r078786/PE2_BS/Bluetooth_music_box/Foto's en filmpjes/pcb_zonder_scherm.PNG

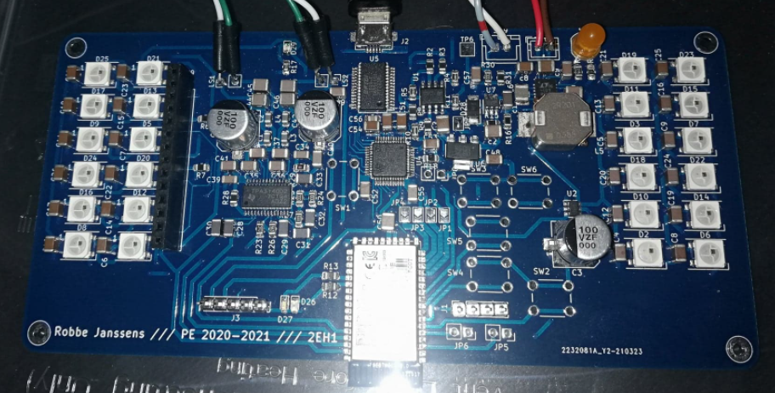
Bluetooth_music_box/Foto's en filmpjes/pcb_zonder_scherm.PNG
