r078786/PE2_BS/Bluetooth_music_box/Foto's en filmpjes/pcb_met_scherm.PNG

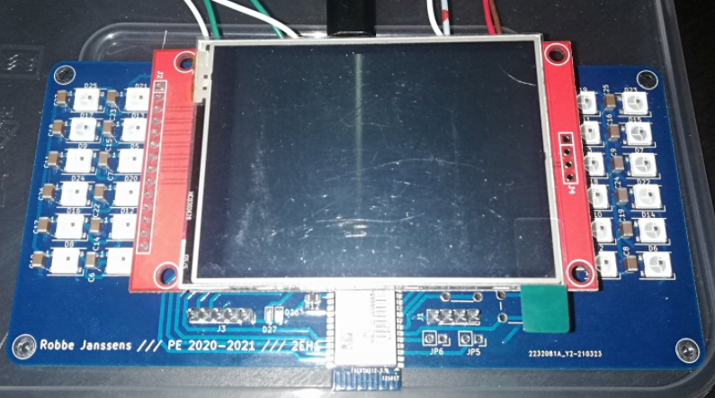
Bluetooth_music_box/Foto's en filmpjes/pcb_met_scherm.PNG
