r078786/PE2_BS/Bluetooth_music_box/Verdediging.pptx

## BlueTooth speaker

Practice Enterprise 2020 – 2021
Thomas More
2EH1: Robbe Janssens

## Wat ?

- Inleiding
- Eigenlijke inhoud
- Besluit

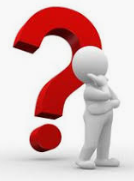
[picture p19: figure]

## Slide 3

Inleiding

- BlueTooth Speaker
- Programmeer-, mechanische, elektronische kennis

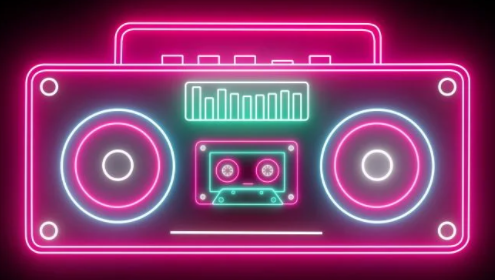
[picture p20: figure]
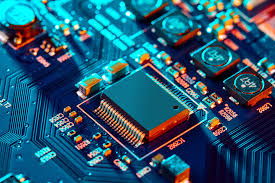
[picture p21: figure]
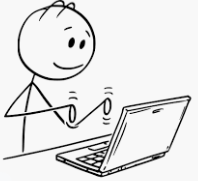
[picture p22: figure]

## Slide 4

Inleiding

- Duidelijk idee
  - (blok)schema’s

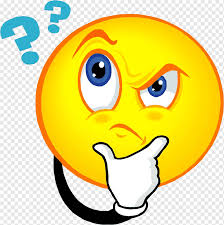
[picture p23: figure]

## Slide 5

Inleiding

- Componenten

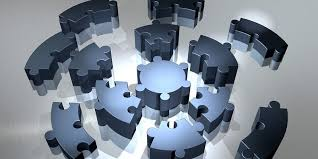
[picture p24: figure]
The 5 Main Components of ERP Software You Need

## Slide 6

Inleiding

- Schema / PCB

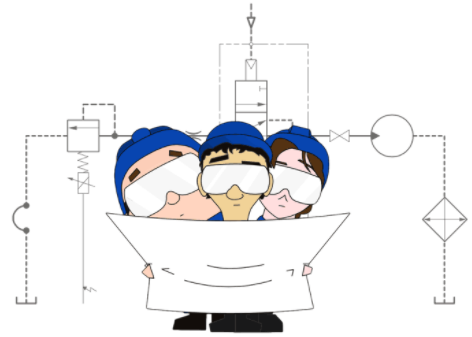
[picture p25: figure]
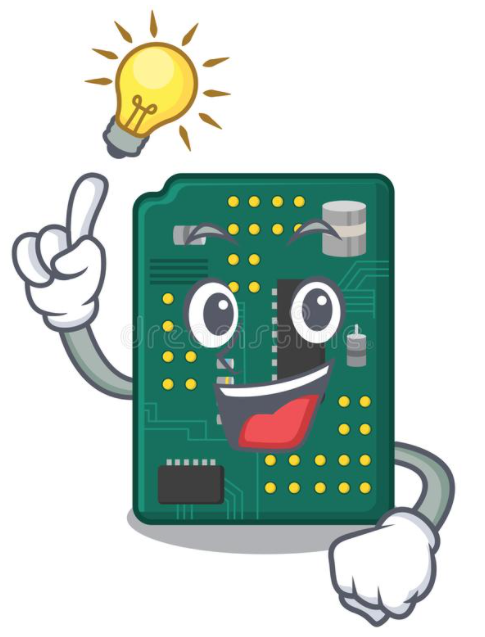
[picture p26: figure]

## Slide 7

Inleiding

- Mechanica

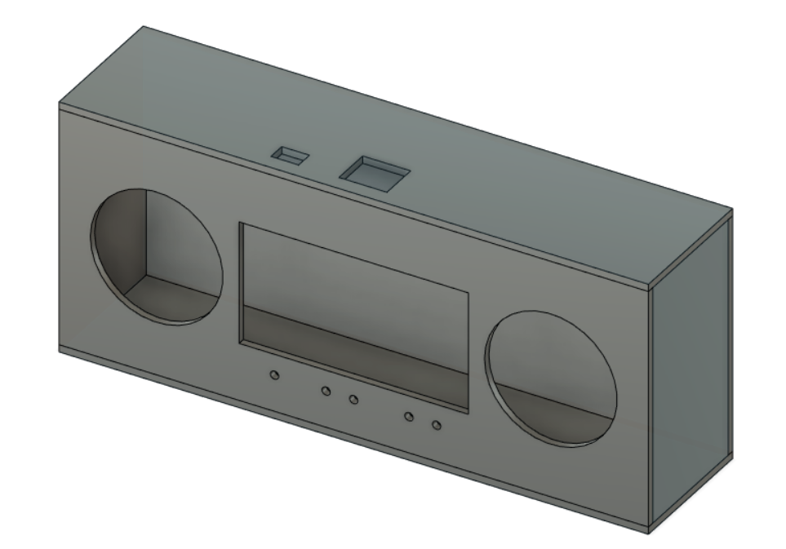
[picture p27: figure]

## Slide 8

Inleiding

- Reflectie

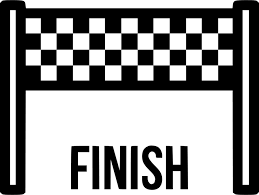
[picture p28: figure]
Line Cartoon clipart - Text, Black, Games, transparent clip art

## Slide 9


Eigenlijke inhoud

- (blok)schema’s

## Slide 10

Eigenlijke inhoud

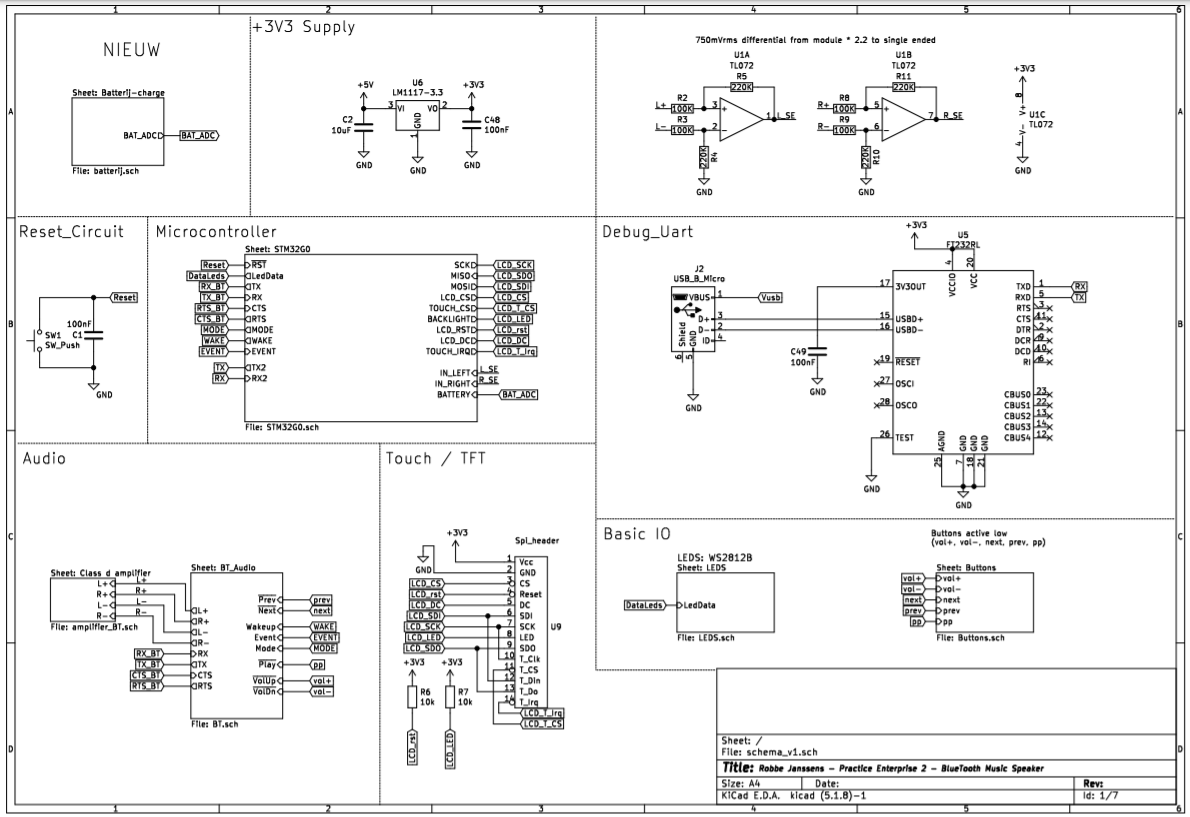
[picture p29: figure]

- Hardware
  - Schematic

## Slide 11

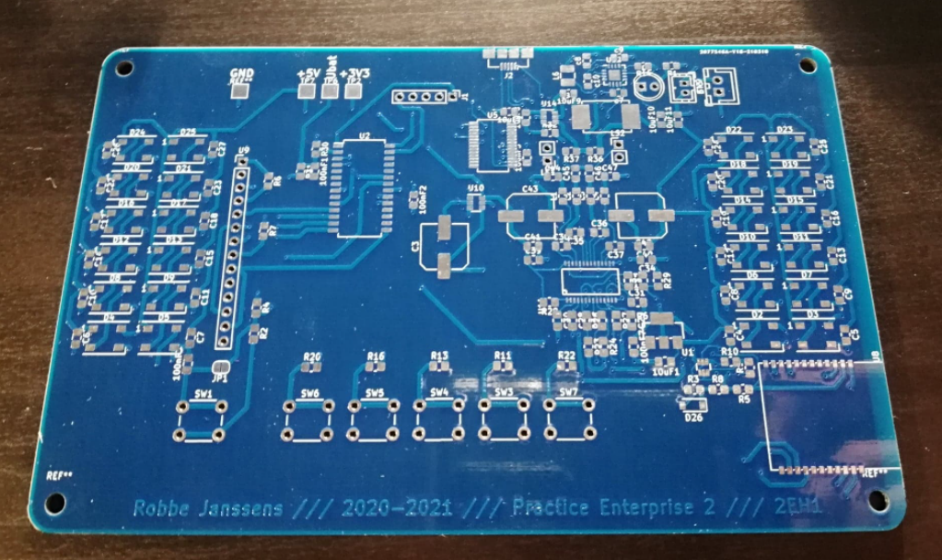
[picture p30: figure]

Eigenlijke inhoud

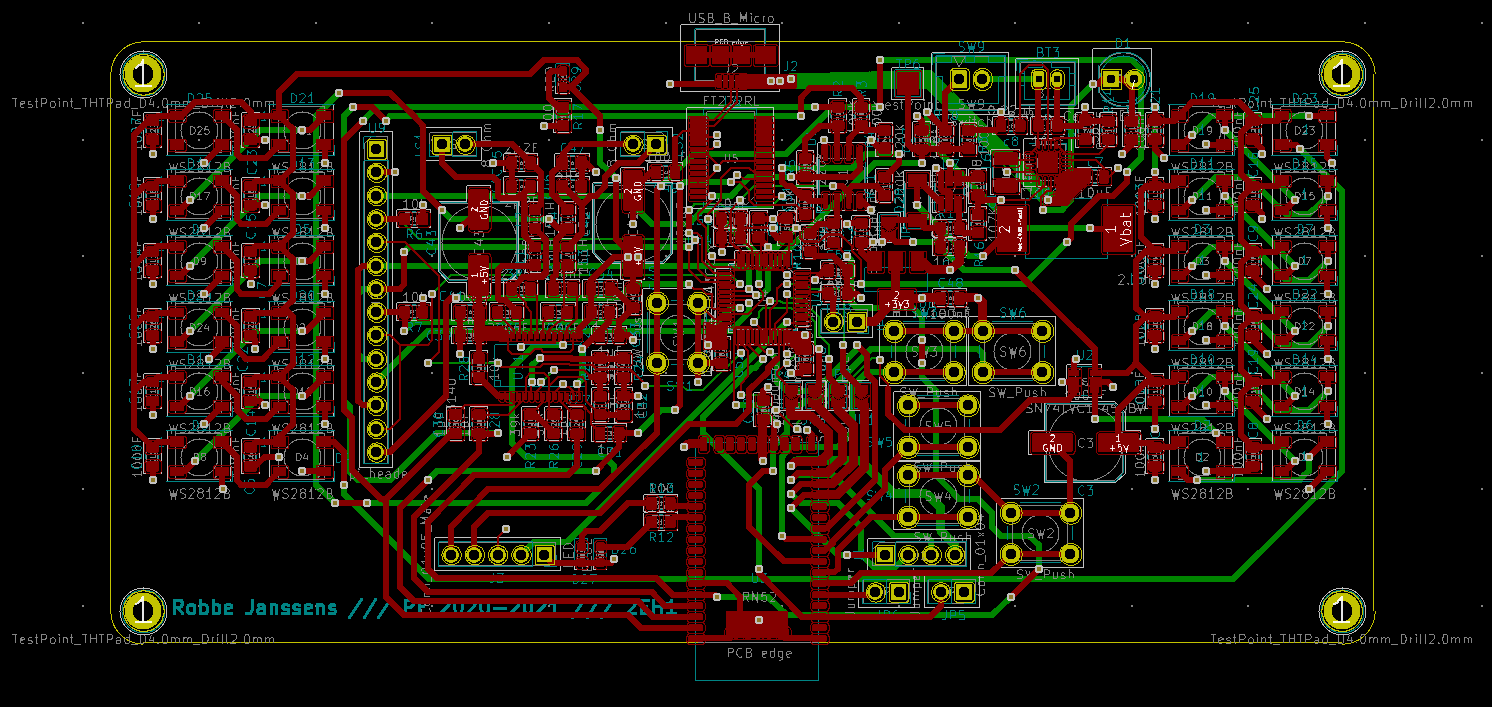
[picture p31: figure]

- Hardware
  - PCB

## Slide 12

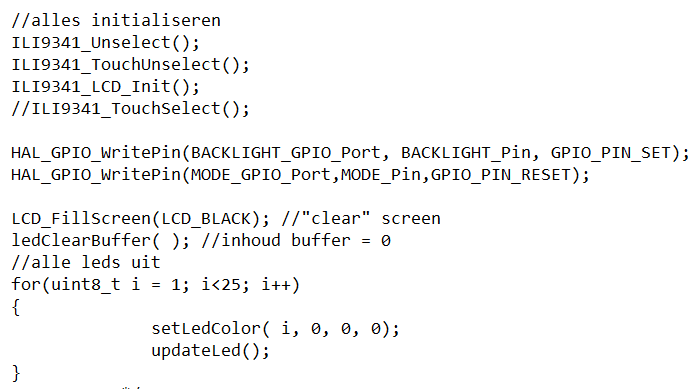
[picture p32: figure]

Eigenlijke inhoud

- Software
  - Flow

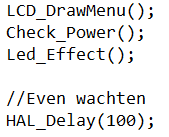
[picture p33: figure]

## Slide 13

Eigenlijke inhoud

- Mechanisch
  - Behuizing

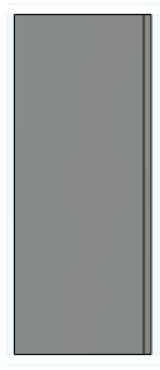
[picture p34: figure]
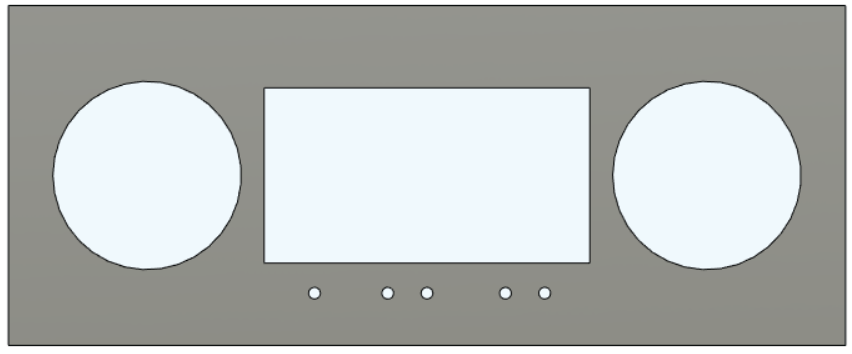
[picture p35: figure]
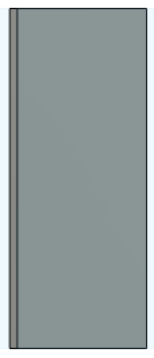
[picture p36: figure]

## Slide 14

Besluit

- Doelstelling
- Discussiepunten
- Reflectie
  - Project
  - Opmerkingen

## Slide 15

Bedankt voor uw aandacht

Practice Enterprise 2020 – 2021
Thomas More
2EH1: Robbe Janssens
