r078786/PE2_BS/Bluetooth_music_box/Foto's en filmpjes/behuizing.PNG

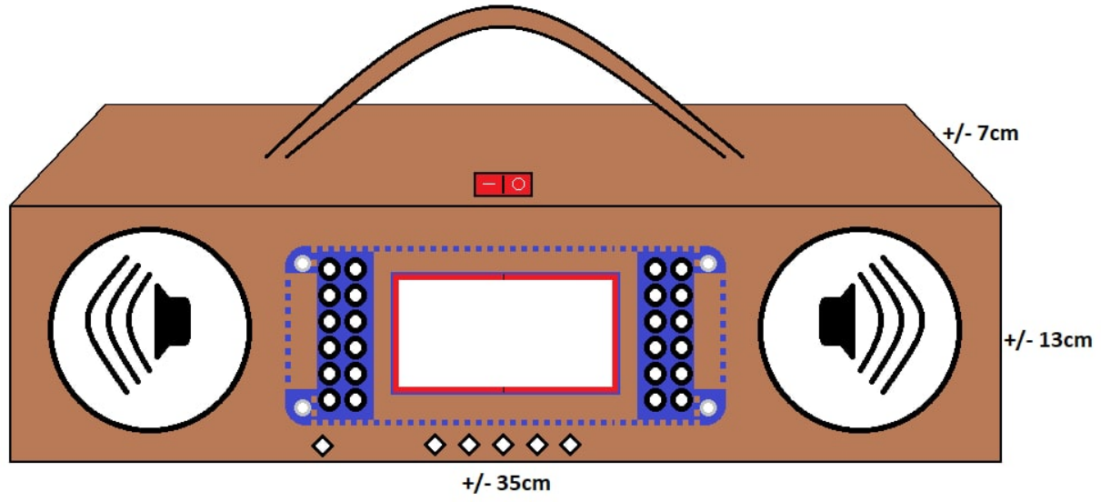
Bluetooth_music_box/Foto's en filmpjes/behuizing.PNG
