r078786/PE2_BS/Bluetooth_music_box/Foto's en filmpjes/nieuwe_pcb.PNG

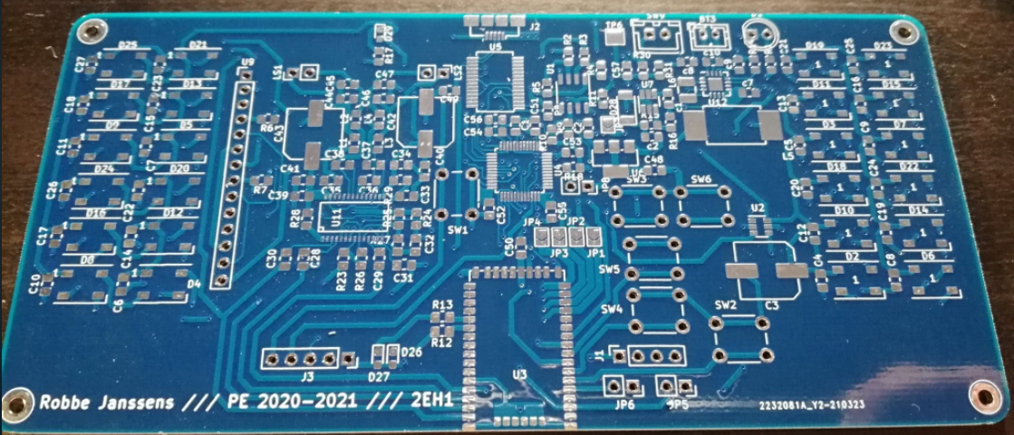
Bluetooth_music_box/Foto's en filmpjes/nieuwe_pcb.PNG
