r078786/PE2_BS/Bluetooth_music_box/Foto's en filmpjes/oude_pcb_VS_nieuwe_pcb_width.PNG

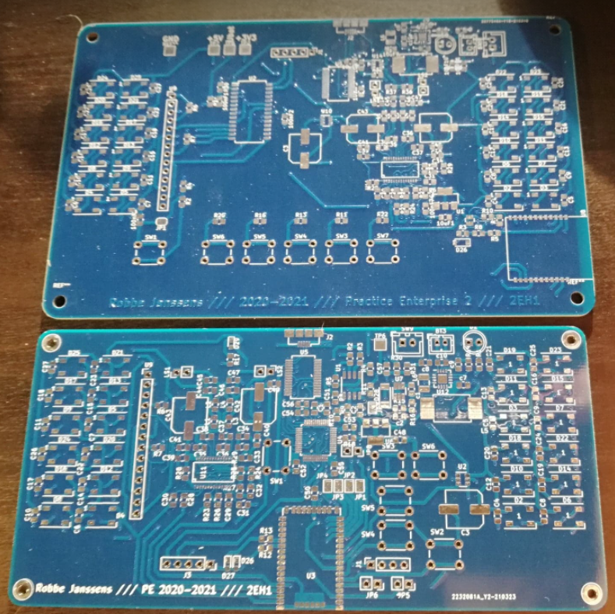
Bluetooth_music_box/Foto's en filmpjes/oude_pcb_VS_nieuwe_pcb_width.PNG
