r078786/PE2_BS/Bluetooth_music_box/Foto's en filmpjes/verbruik berekenen.png

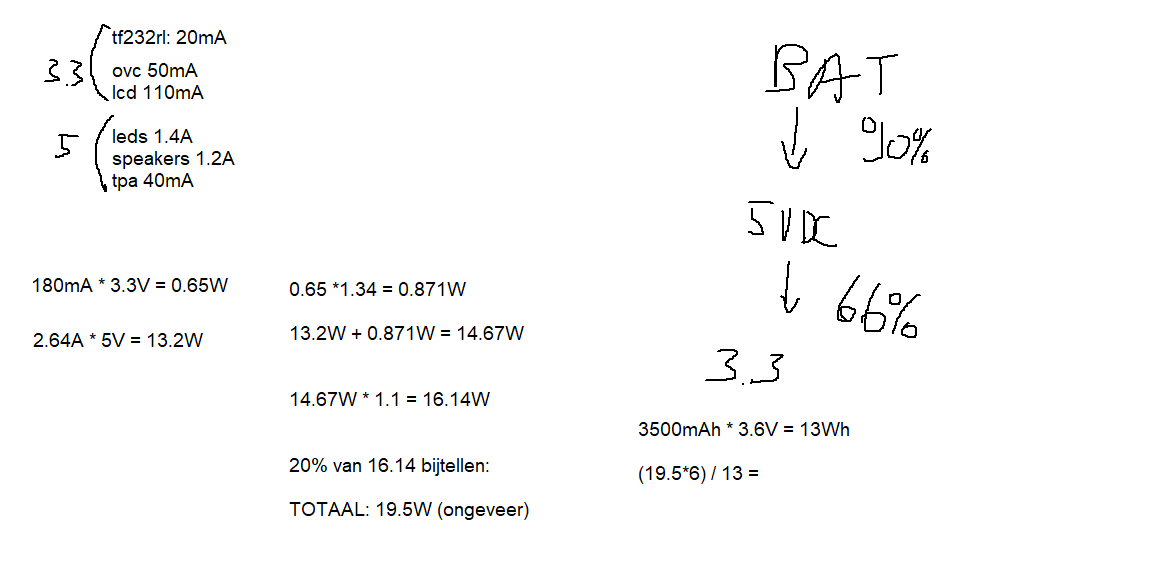
Bluetooth_music_box/Foto's en filmpjes/verbruik berekenen.png
