r078786/PE2_BS/Bluetooth_music_box/Behuizing/top.dxf

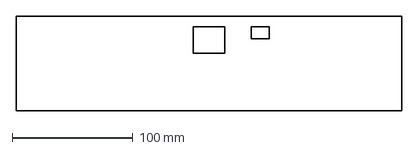
[picture p43: CAD file, 2021-05-17]
Bluetooth_music_box/Behuizing/top.dxf
320.0 x 78.0 mm
