r078786/PE2_BS/Bluetooth_music_box/Behuizing/front.dxf

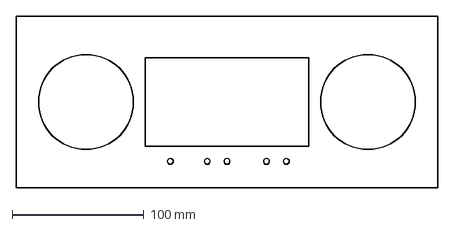
[picture p45: CAD file, 2021-05-17]
Bluetooth_music_box/Behuizing/front.dxf
320.0 x 130.0 mm
