r078786/PE2_BS/Bluetooth_music_box/Behuizing/back.dxf

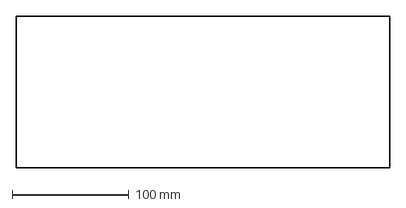
[picture p46: CAD file, 2021-05-17]
Bluetooth_music_box/Behuizing/back.dxf
320.0 x 130.0 mm
