r078786/PE2_BS/Bluetooth_music_box/Behuizing/right.dxf

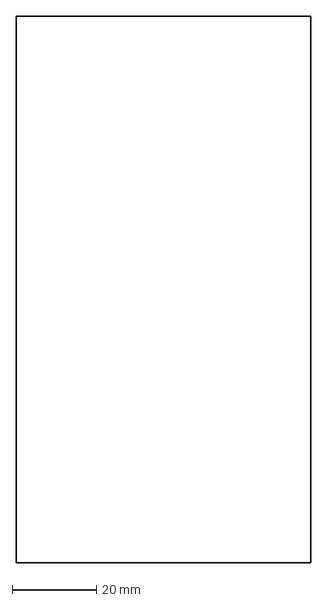
[picture p47: CAD file, 2021-05-17]
Bluetooth_music_box/Behuizing/right.dxf
70.0 x 130.0 mm
