r078786/PE2_BS/Bluetooth_music_box/Behuizing/left.dxf

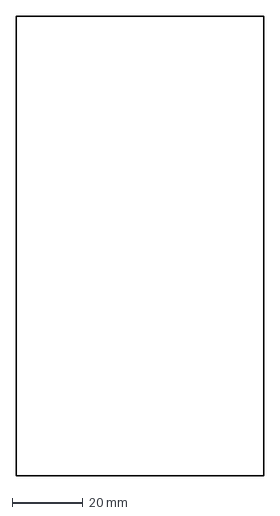
[picture p48: CAD file, 2021-05-13]
Bluetooth_music_box/Behuizing/left.dxf
70.0 x 130.0 mm
