r078786/PE2_BS/Bluetooth_music_box/schema's_en_pcb/schema_v1/Final_schematic.pdf

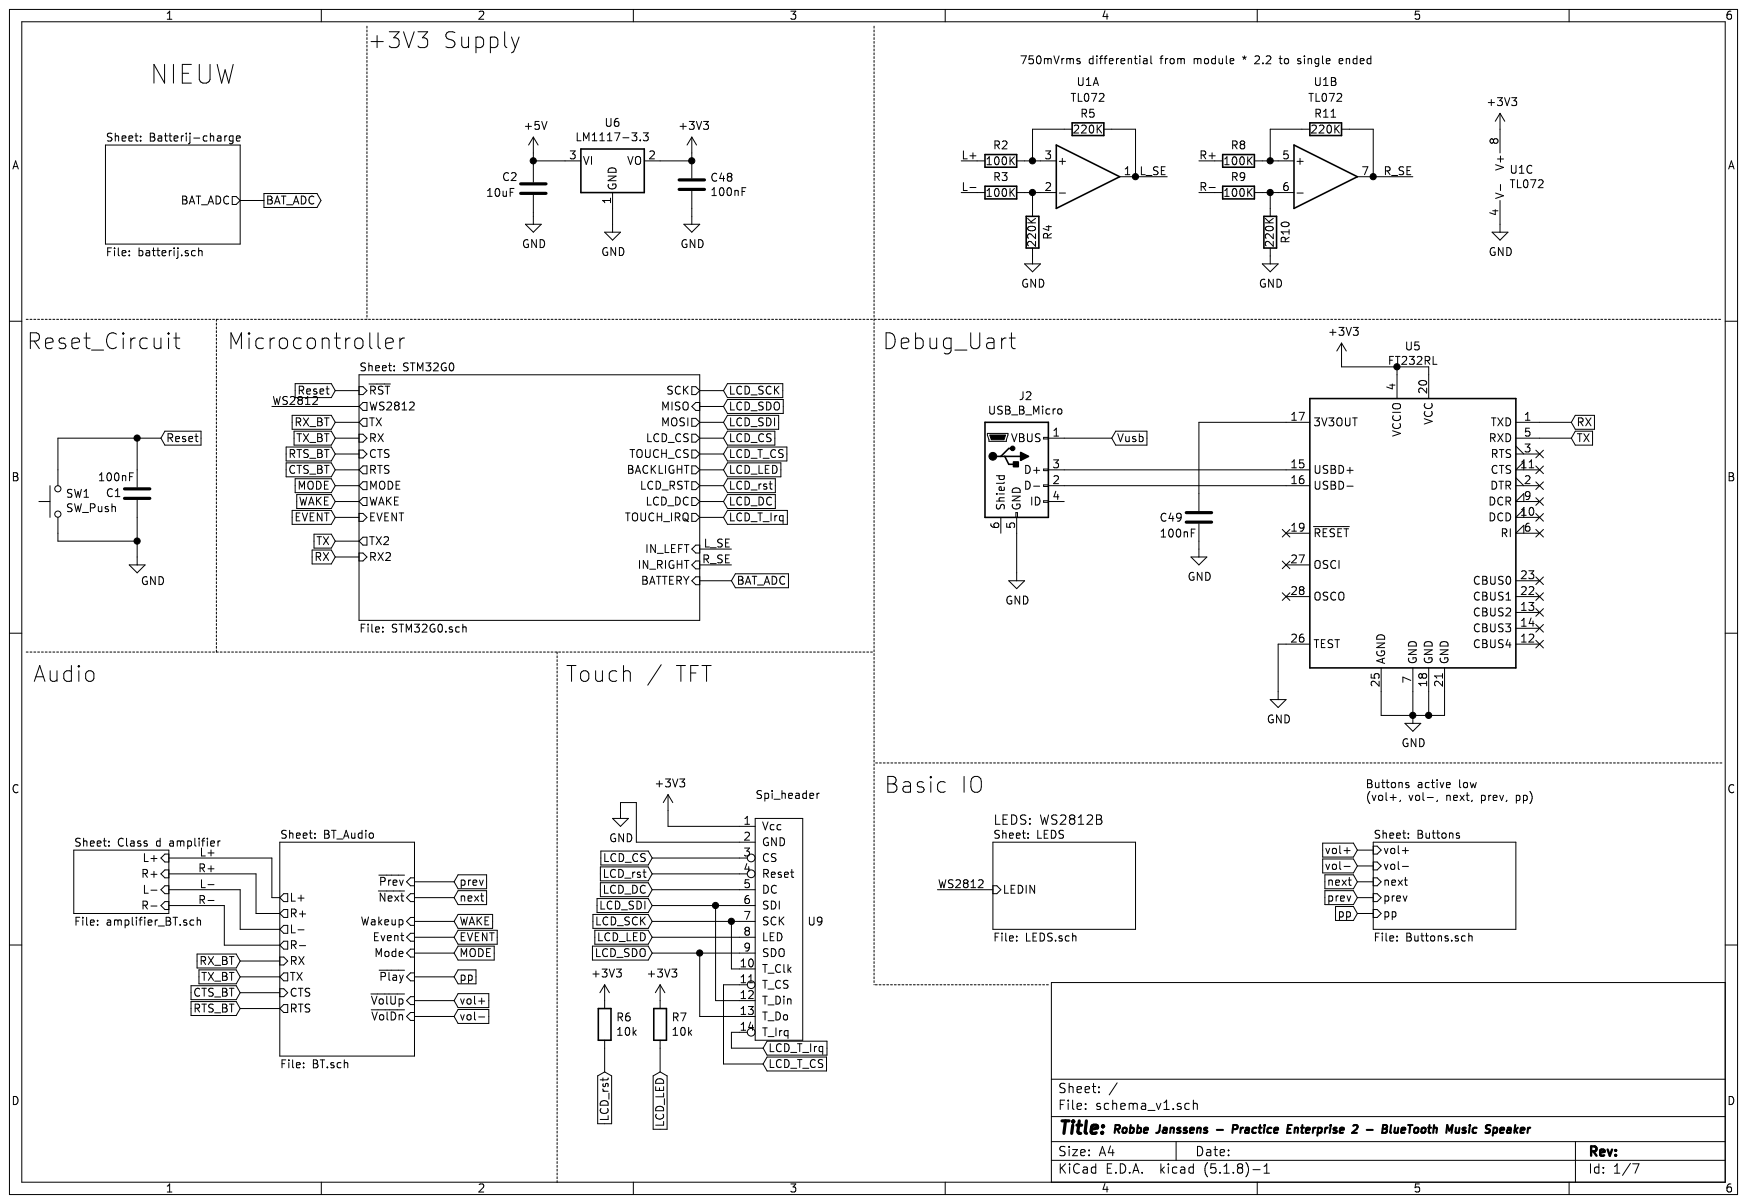
[picture p49: page 1]

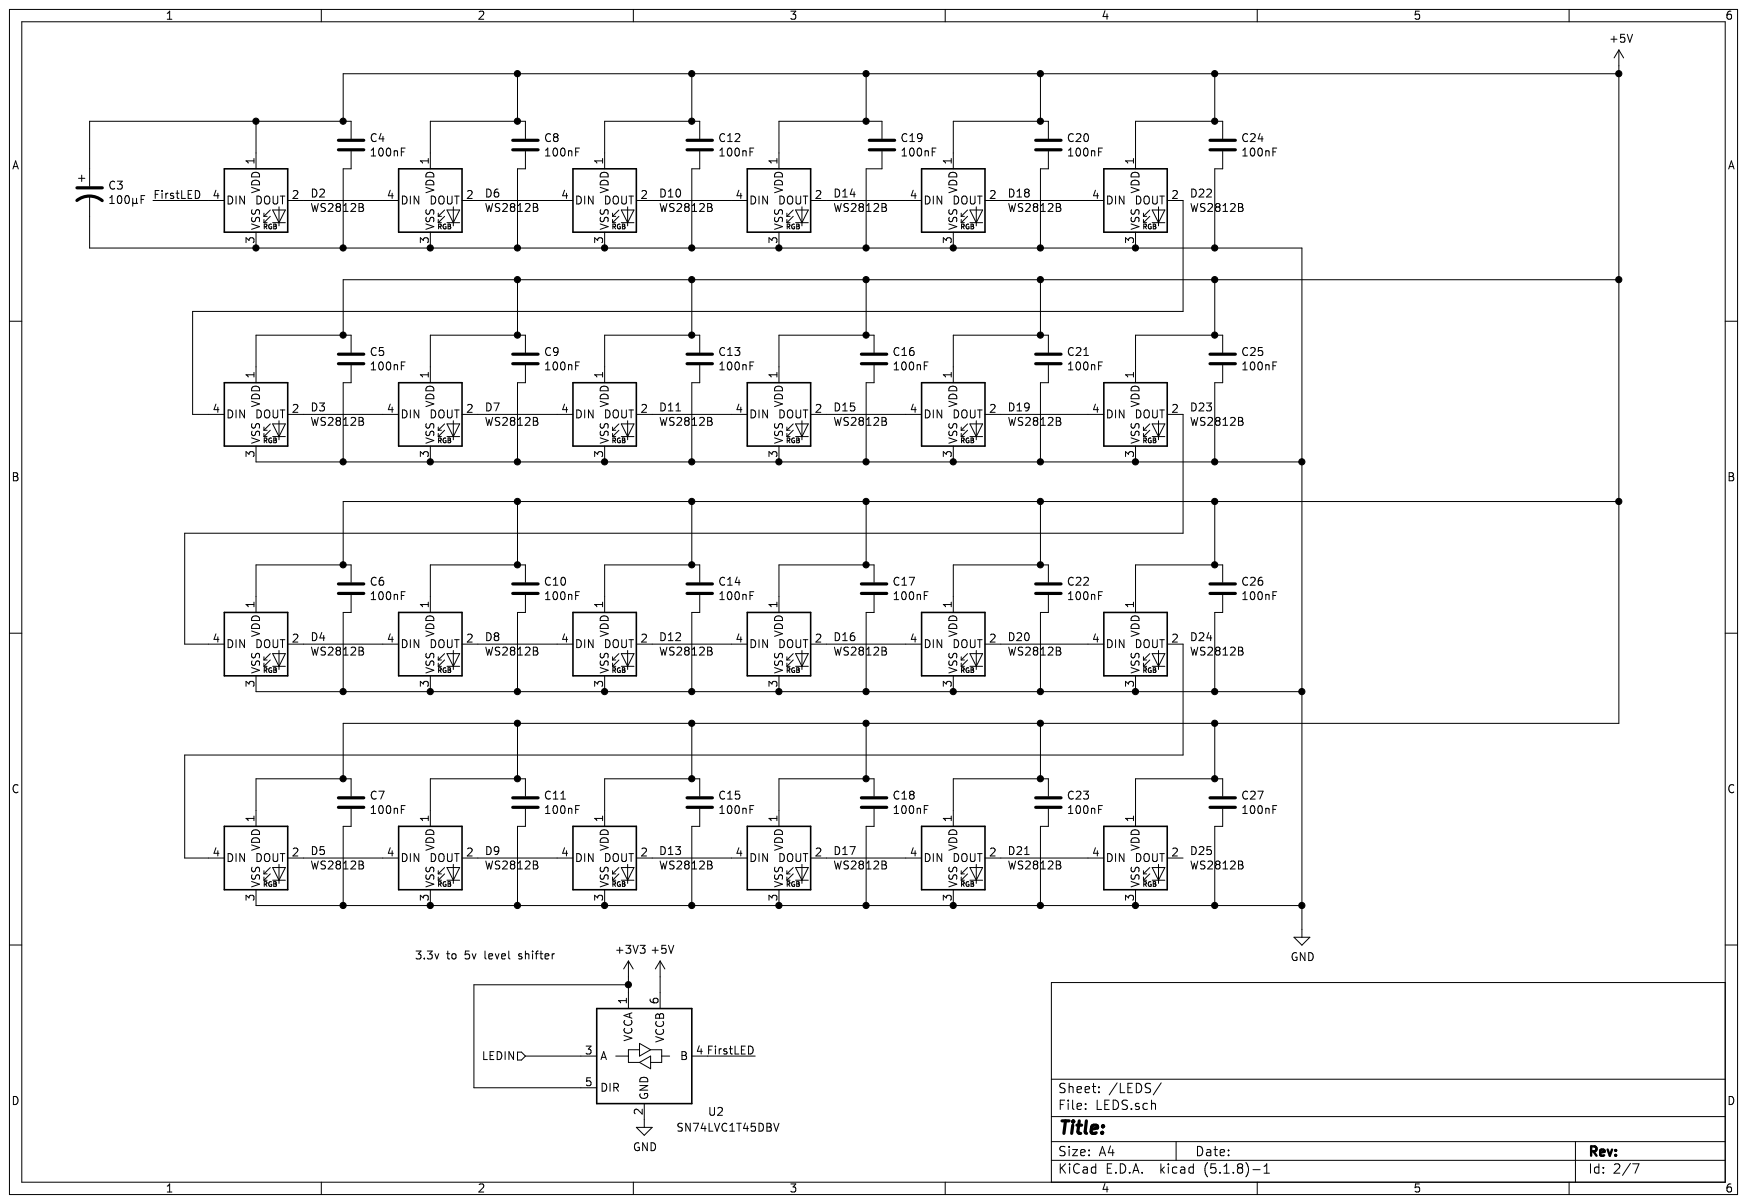
[picture p50: page 2]

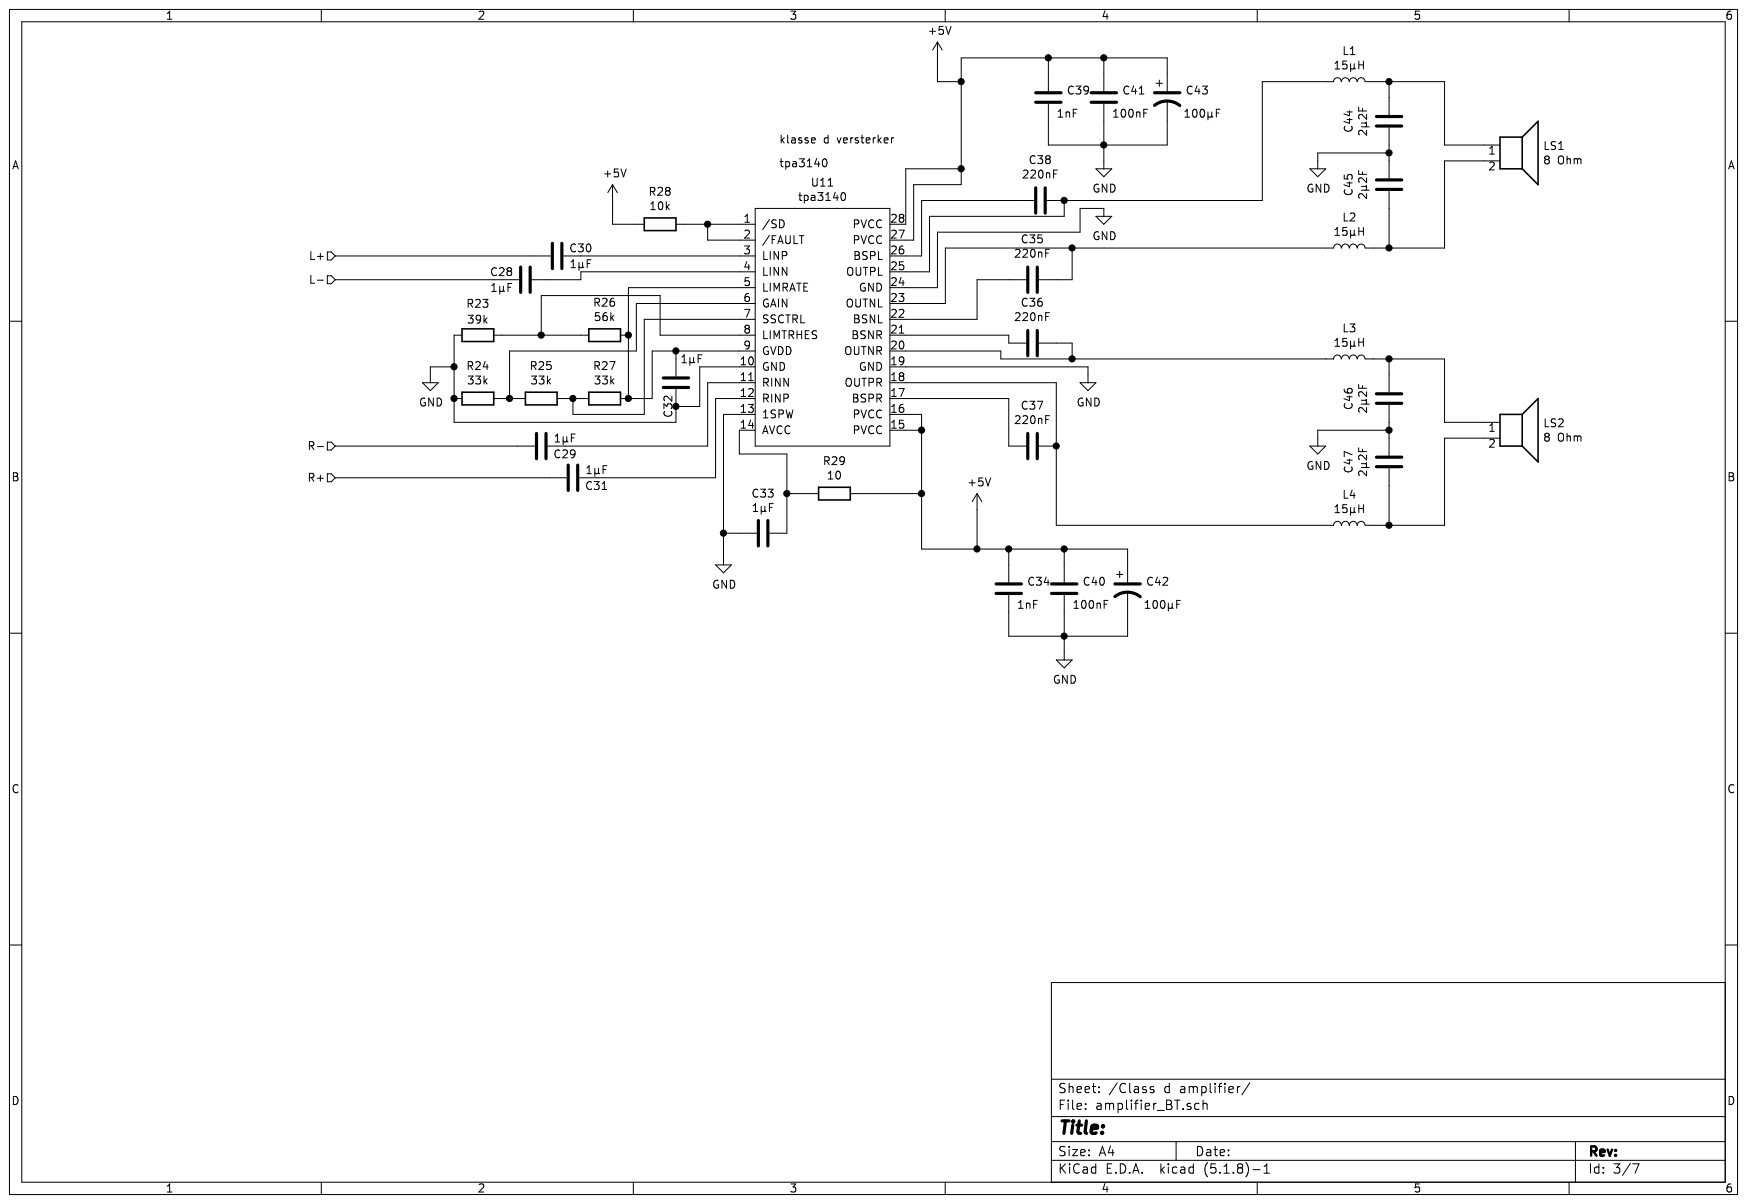
[picture p51: page 3]

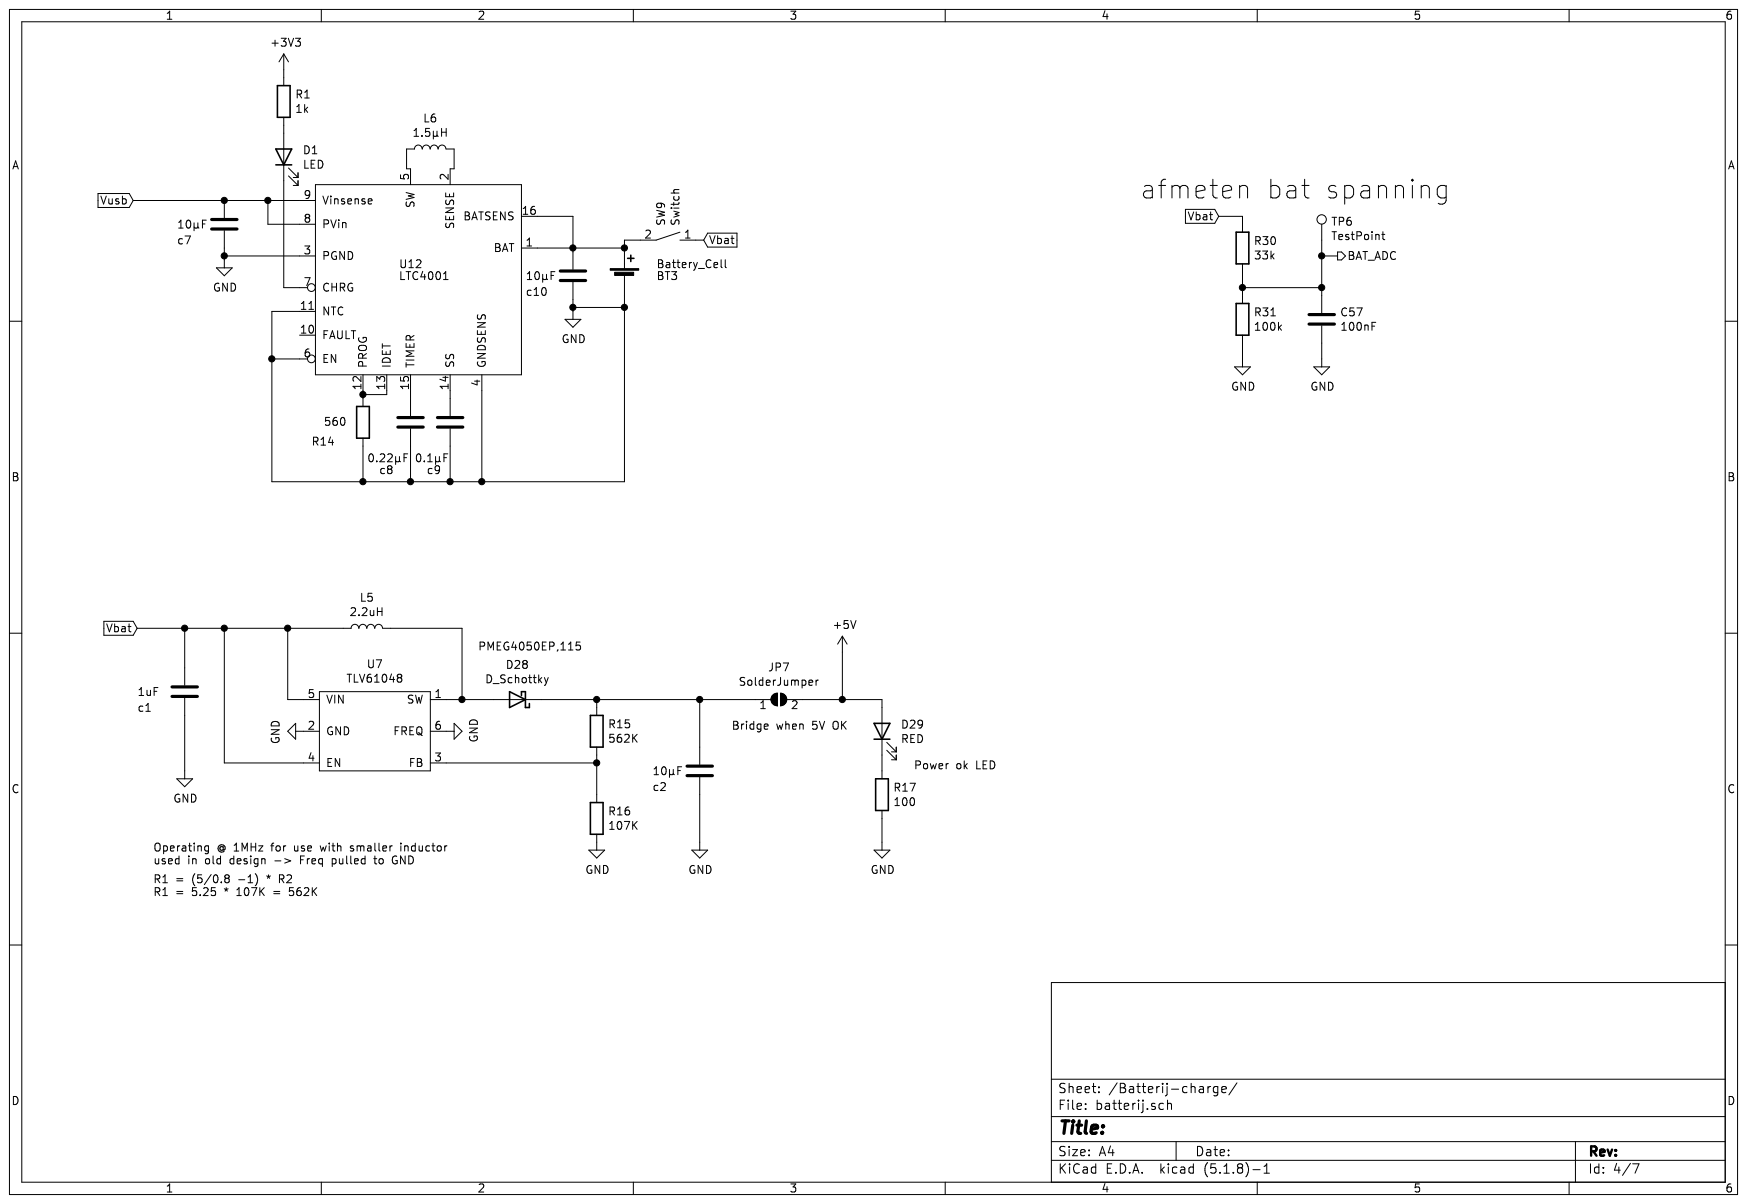
[picture p52: page 4]

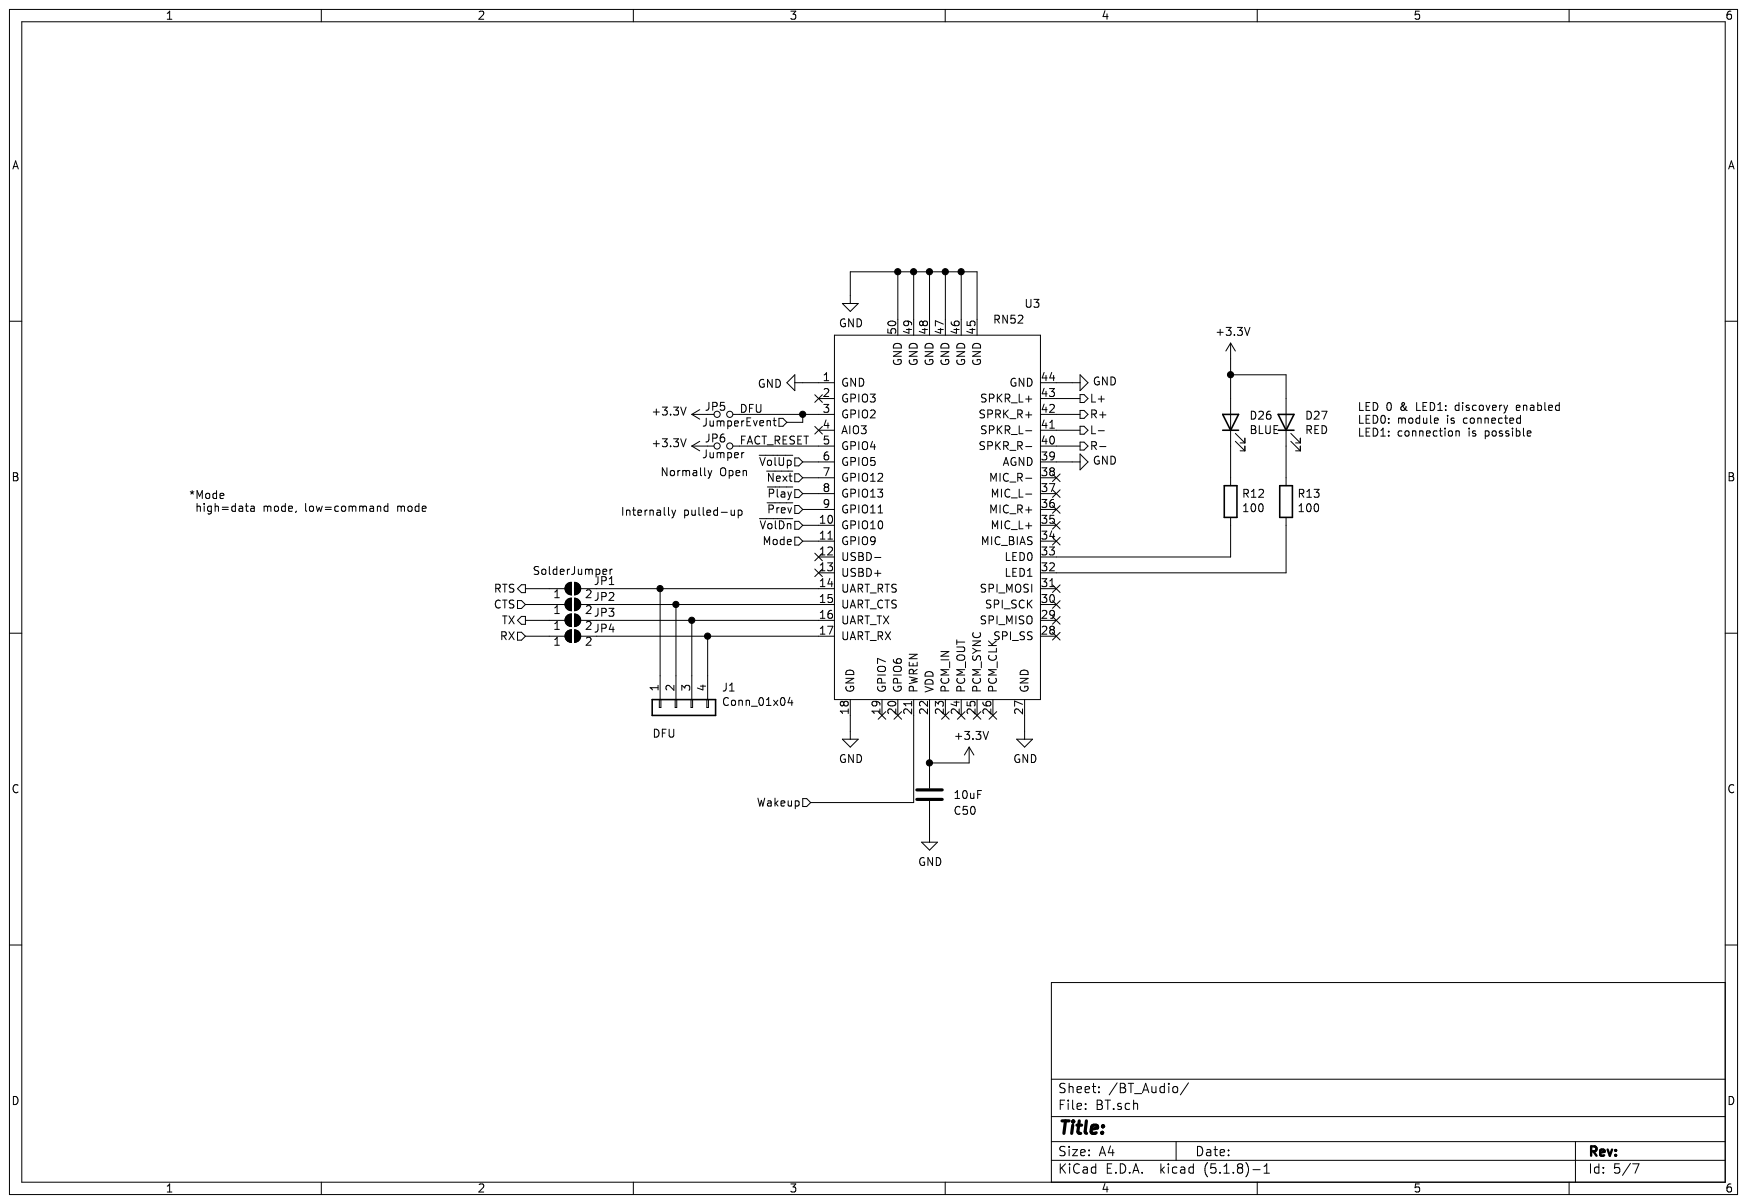
[picture p53: page 5]

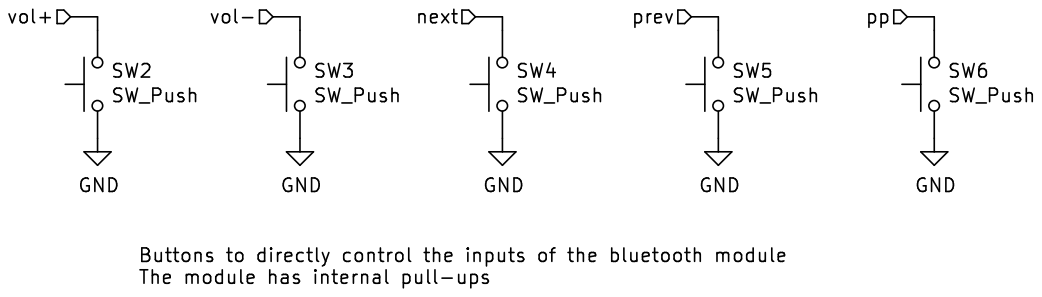
[picture p54: page 6]

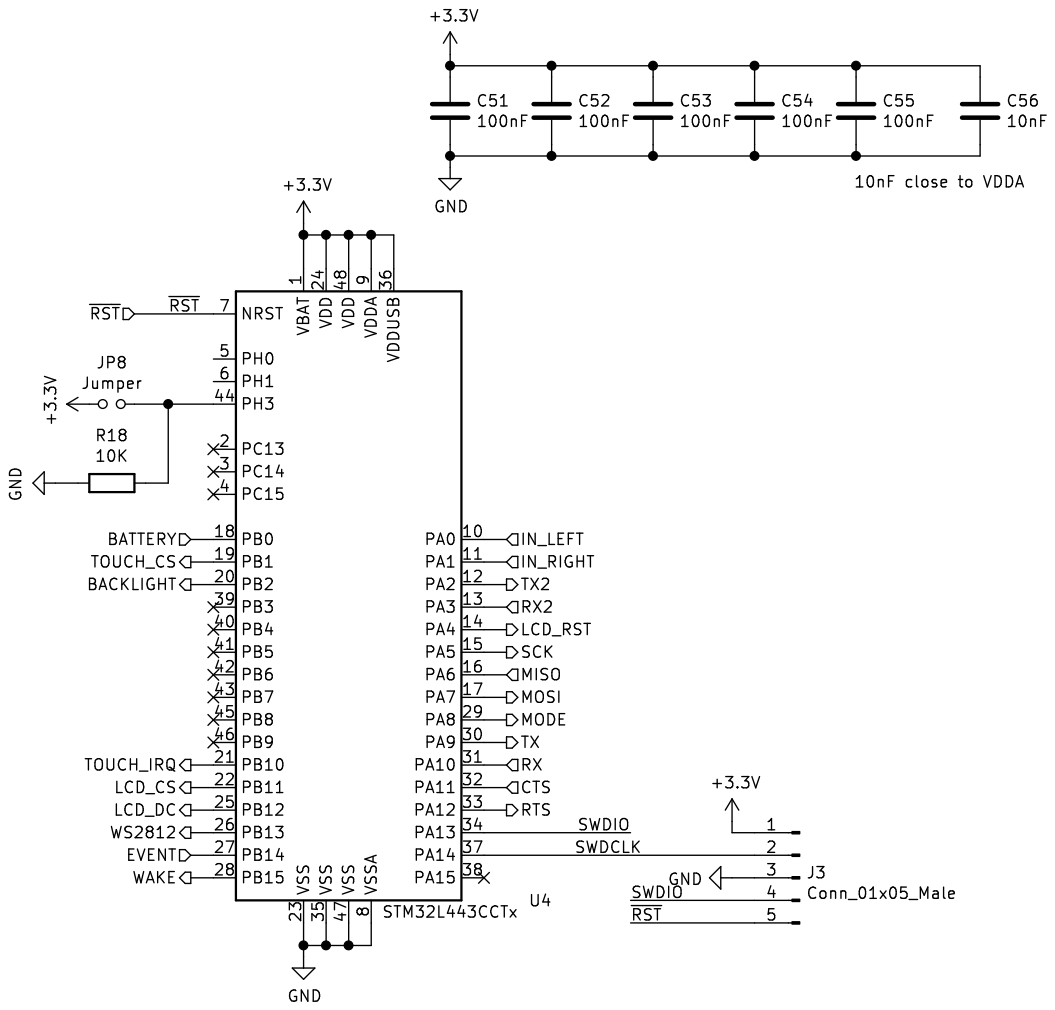
[picture p55: page 7]
