r078786/PE2_BS/Bluetooth_music_box/schema's_en_pcb/schema_v1/schema_robbe5.pdf

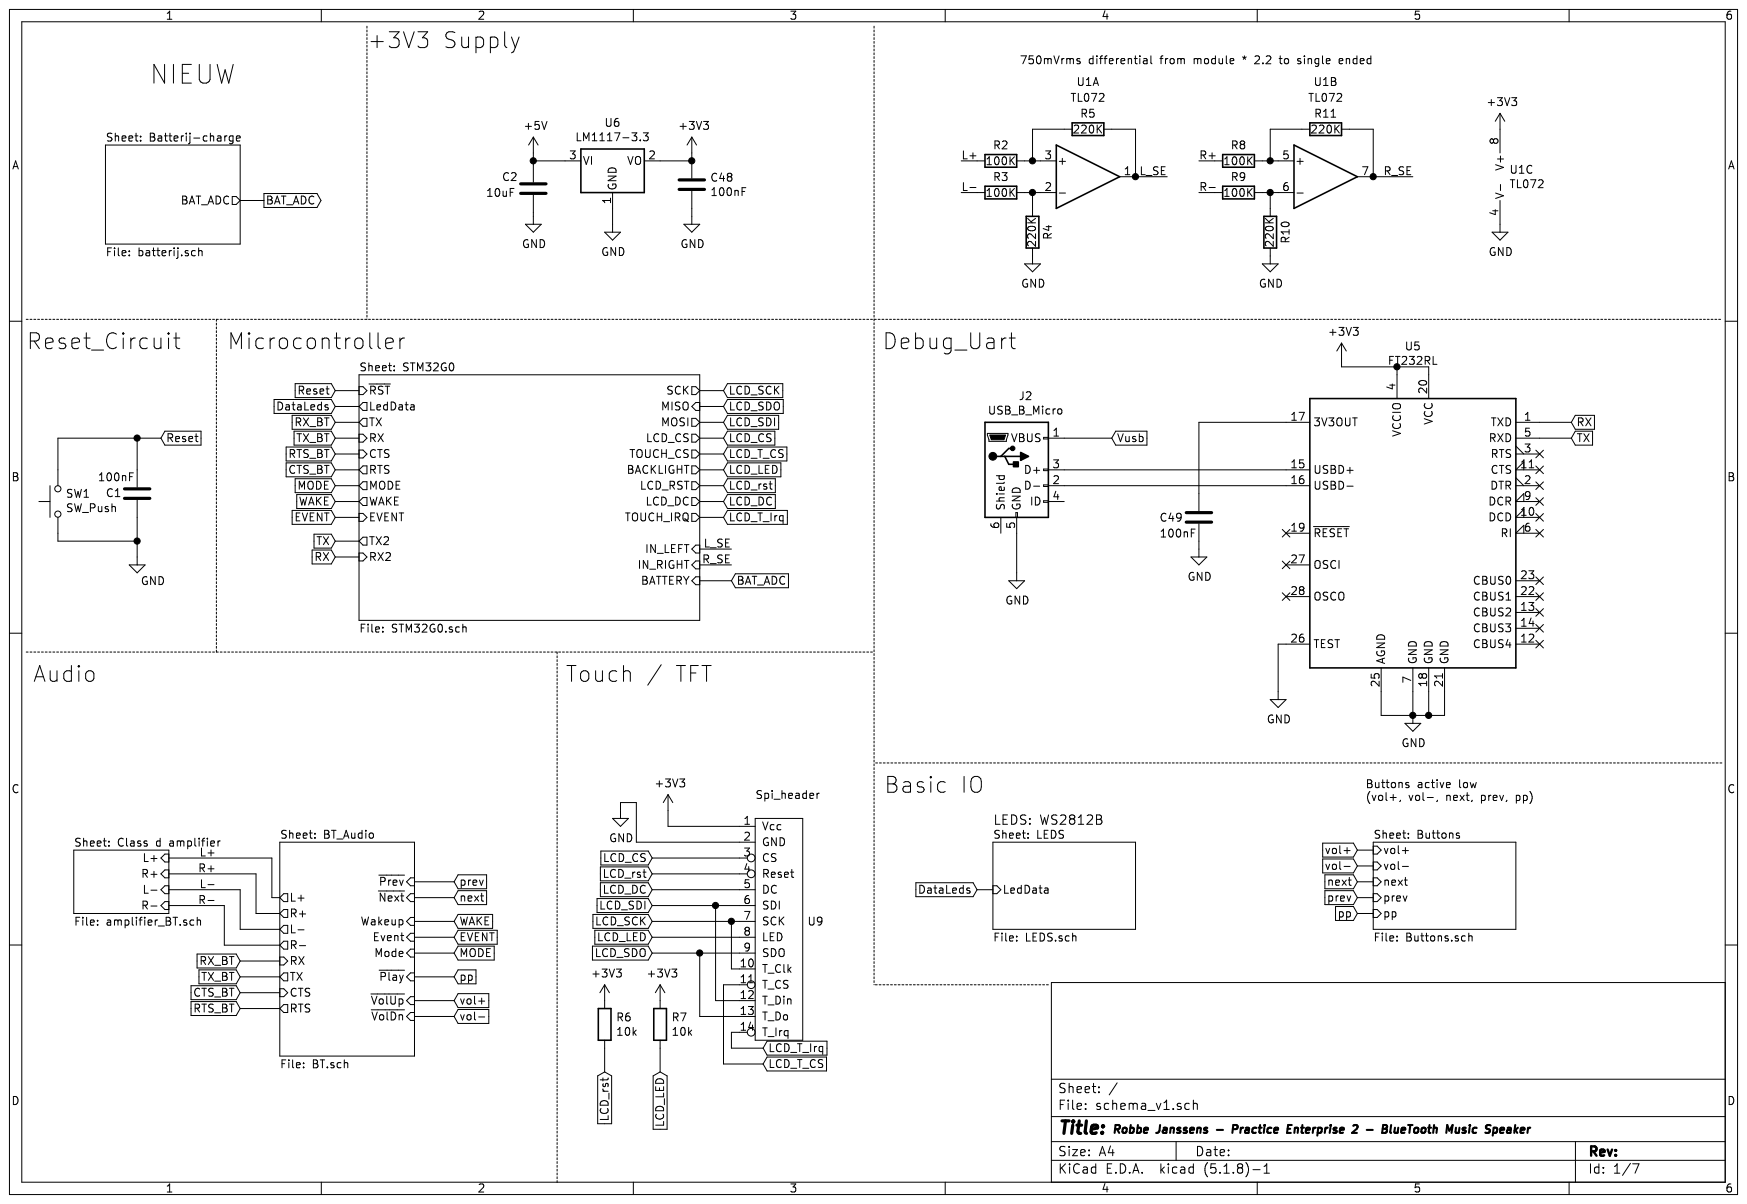
[picture p56: page 1]

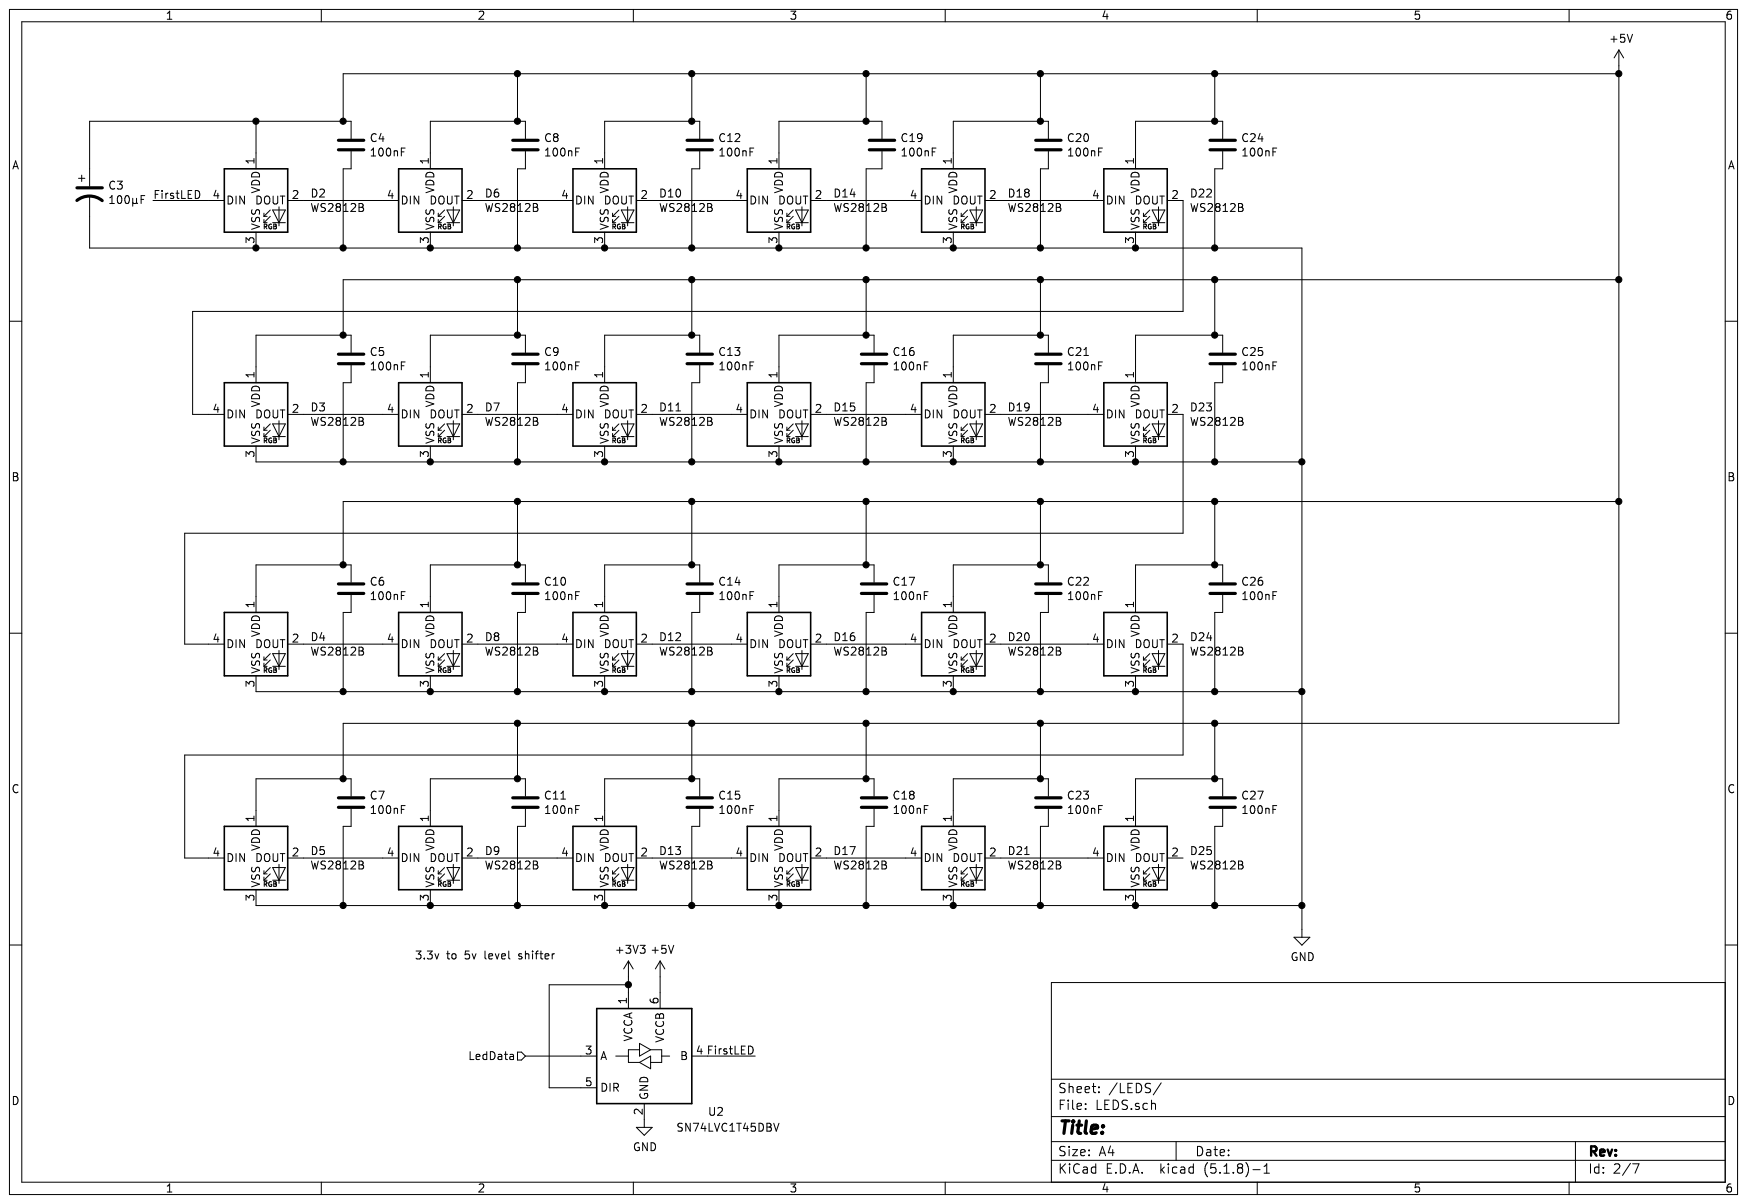
[picture p57: page 2]


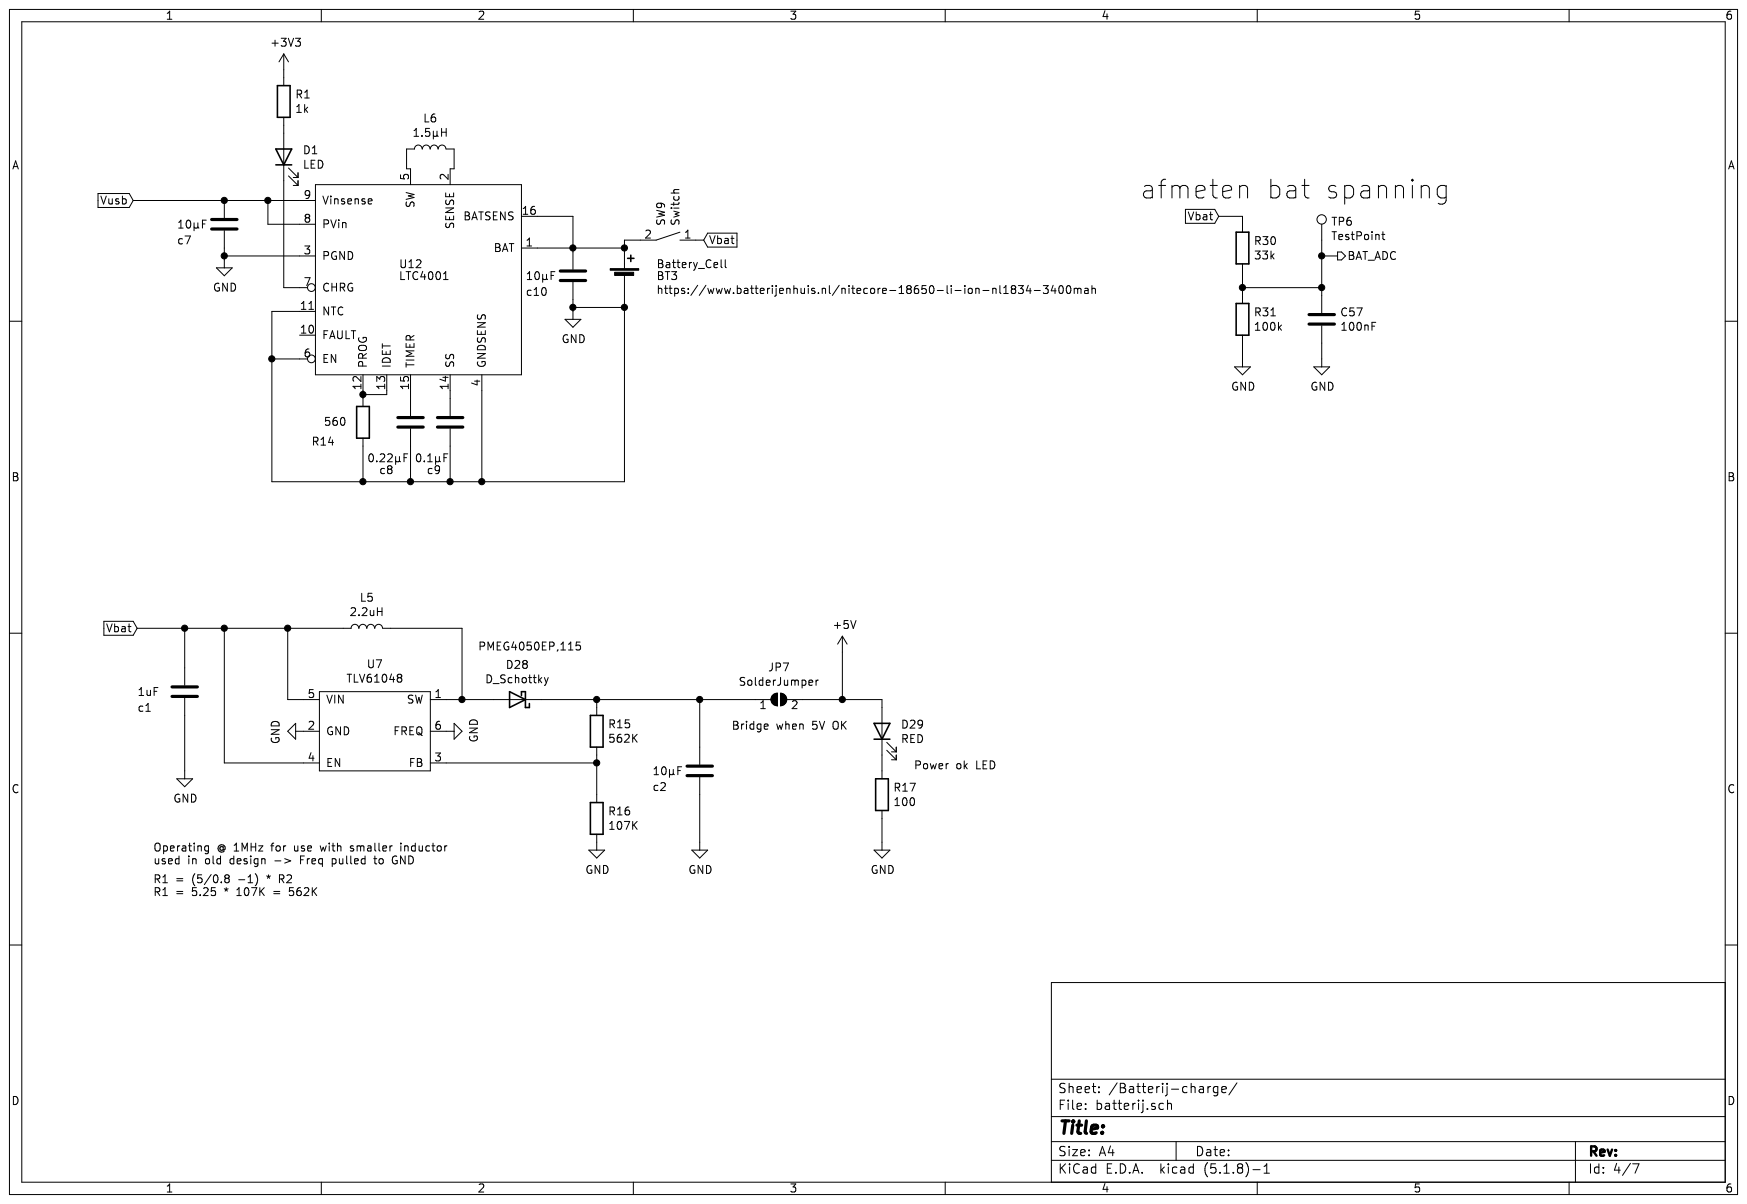
[picture p58: page 4]

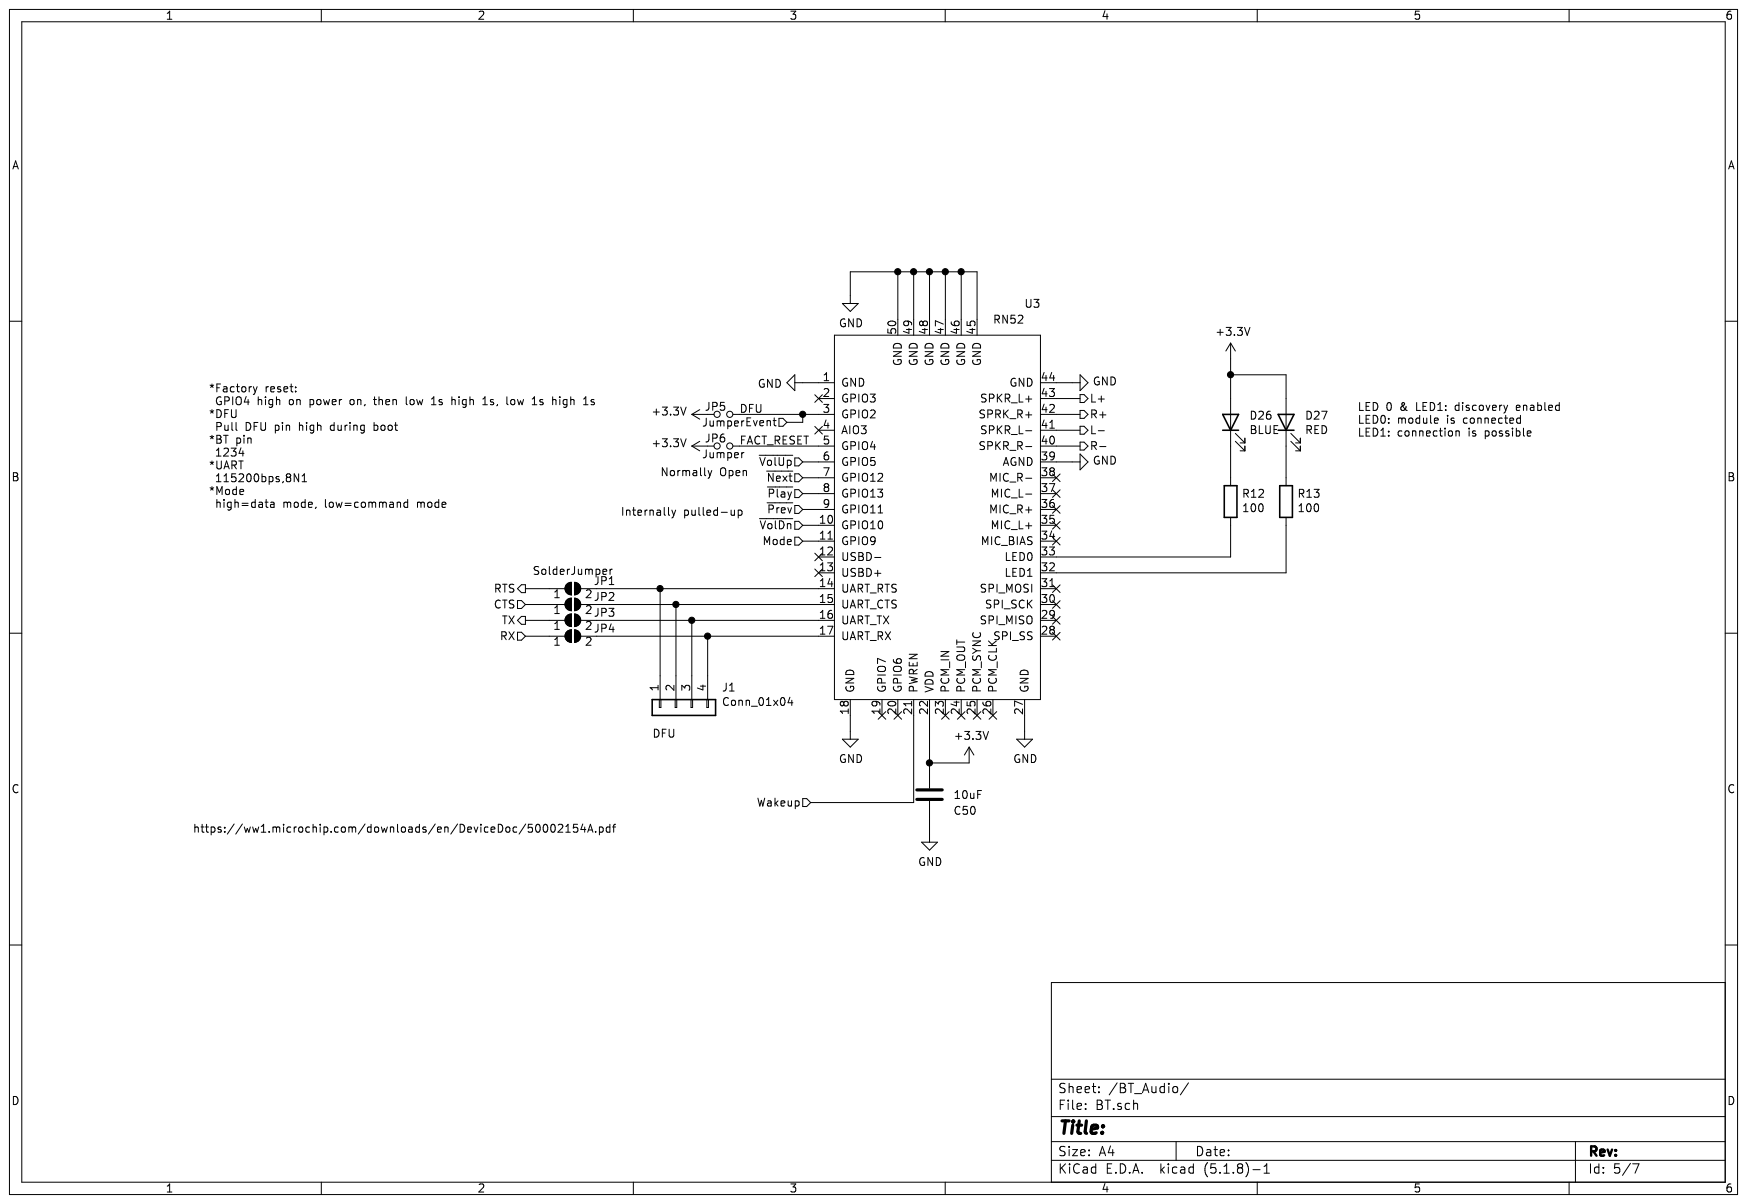
[picture p59: page 5]


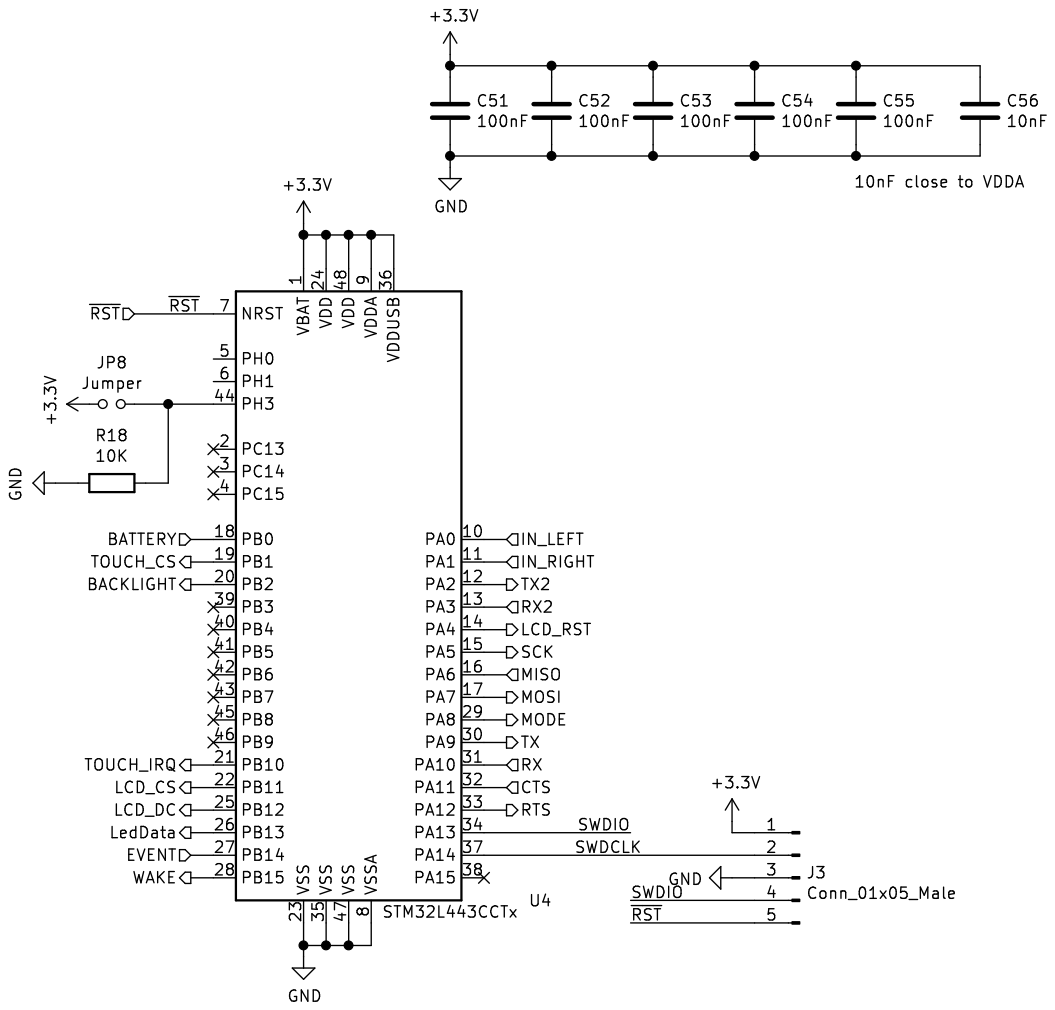
[picture p60: page 7]
