r078786/PE2_BS/Bluetooth_music_box/schema's_en_pcb/schema_v1/schema_robbe4.pdf

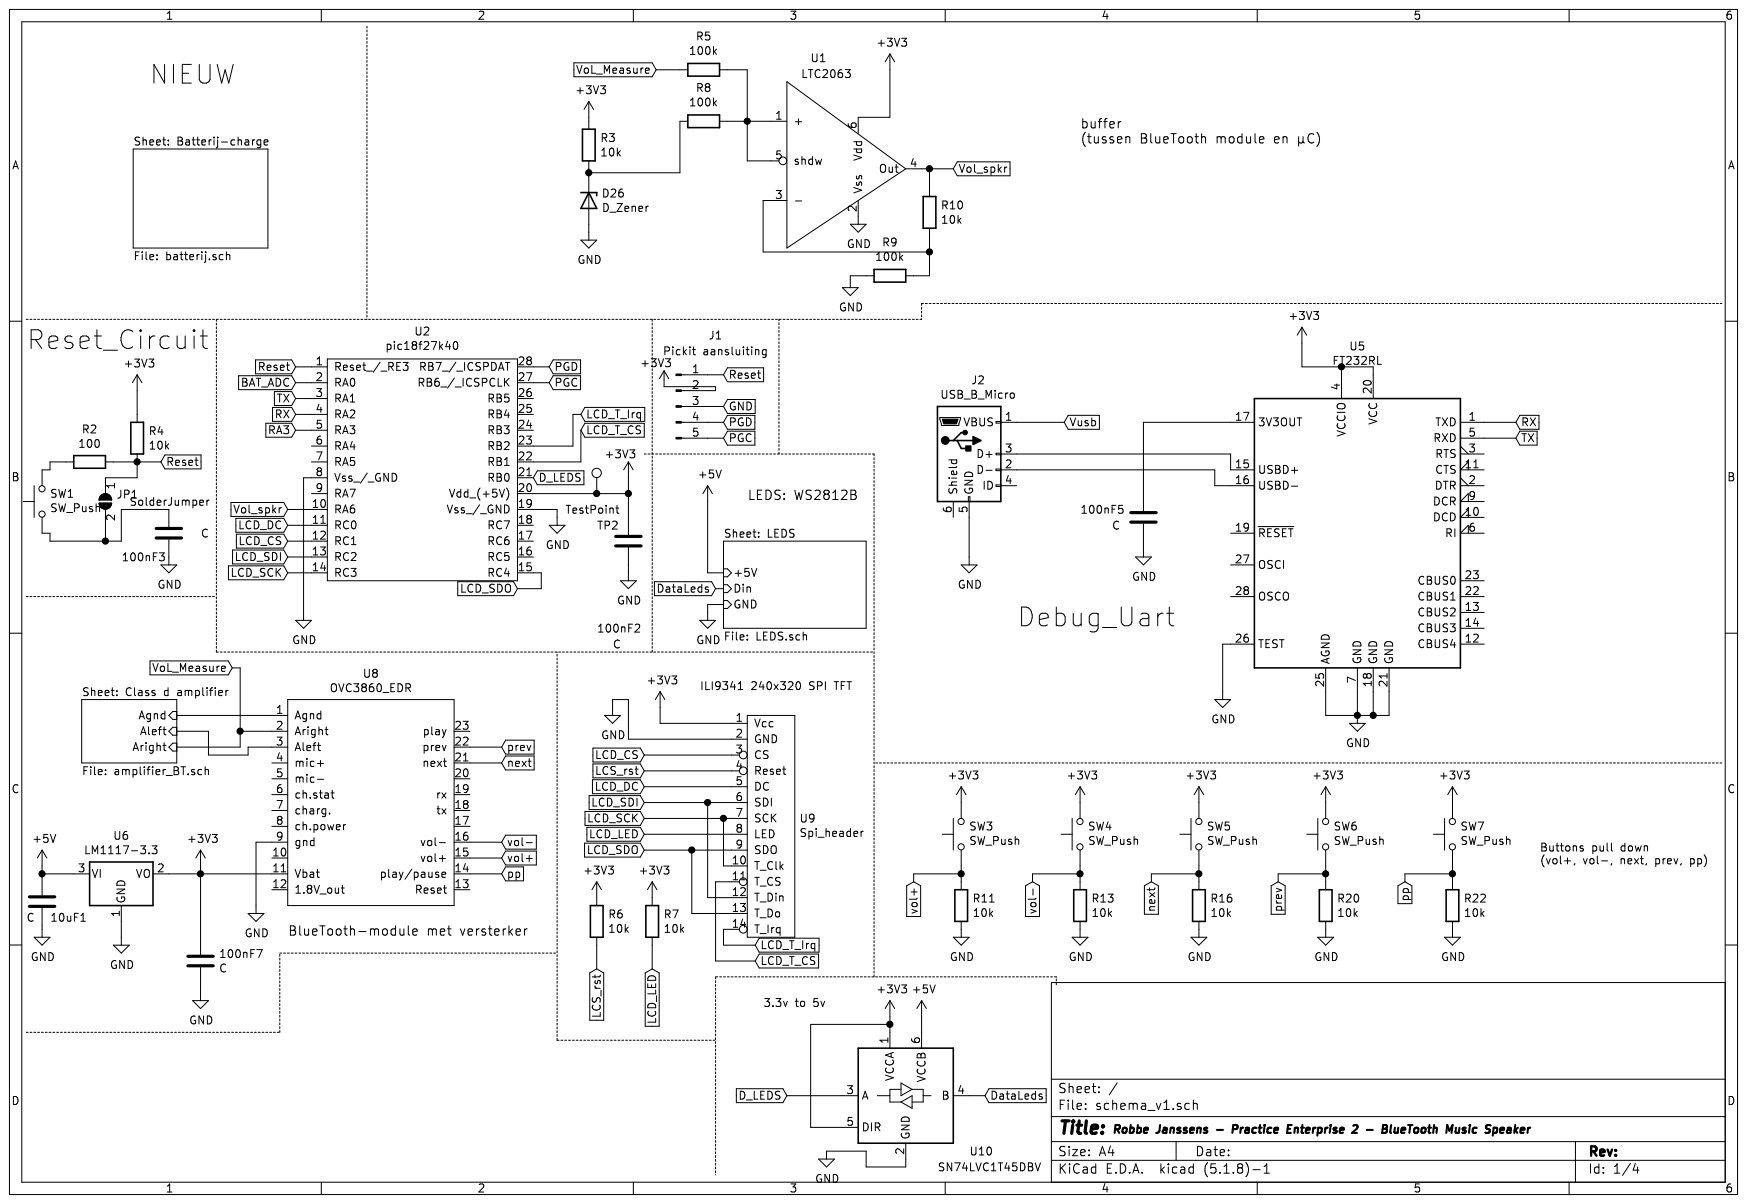
[picture p61: page 1]

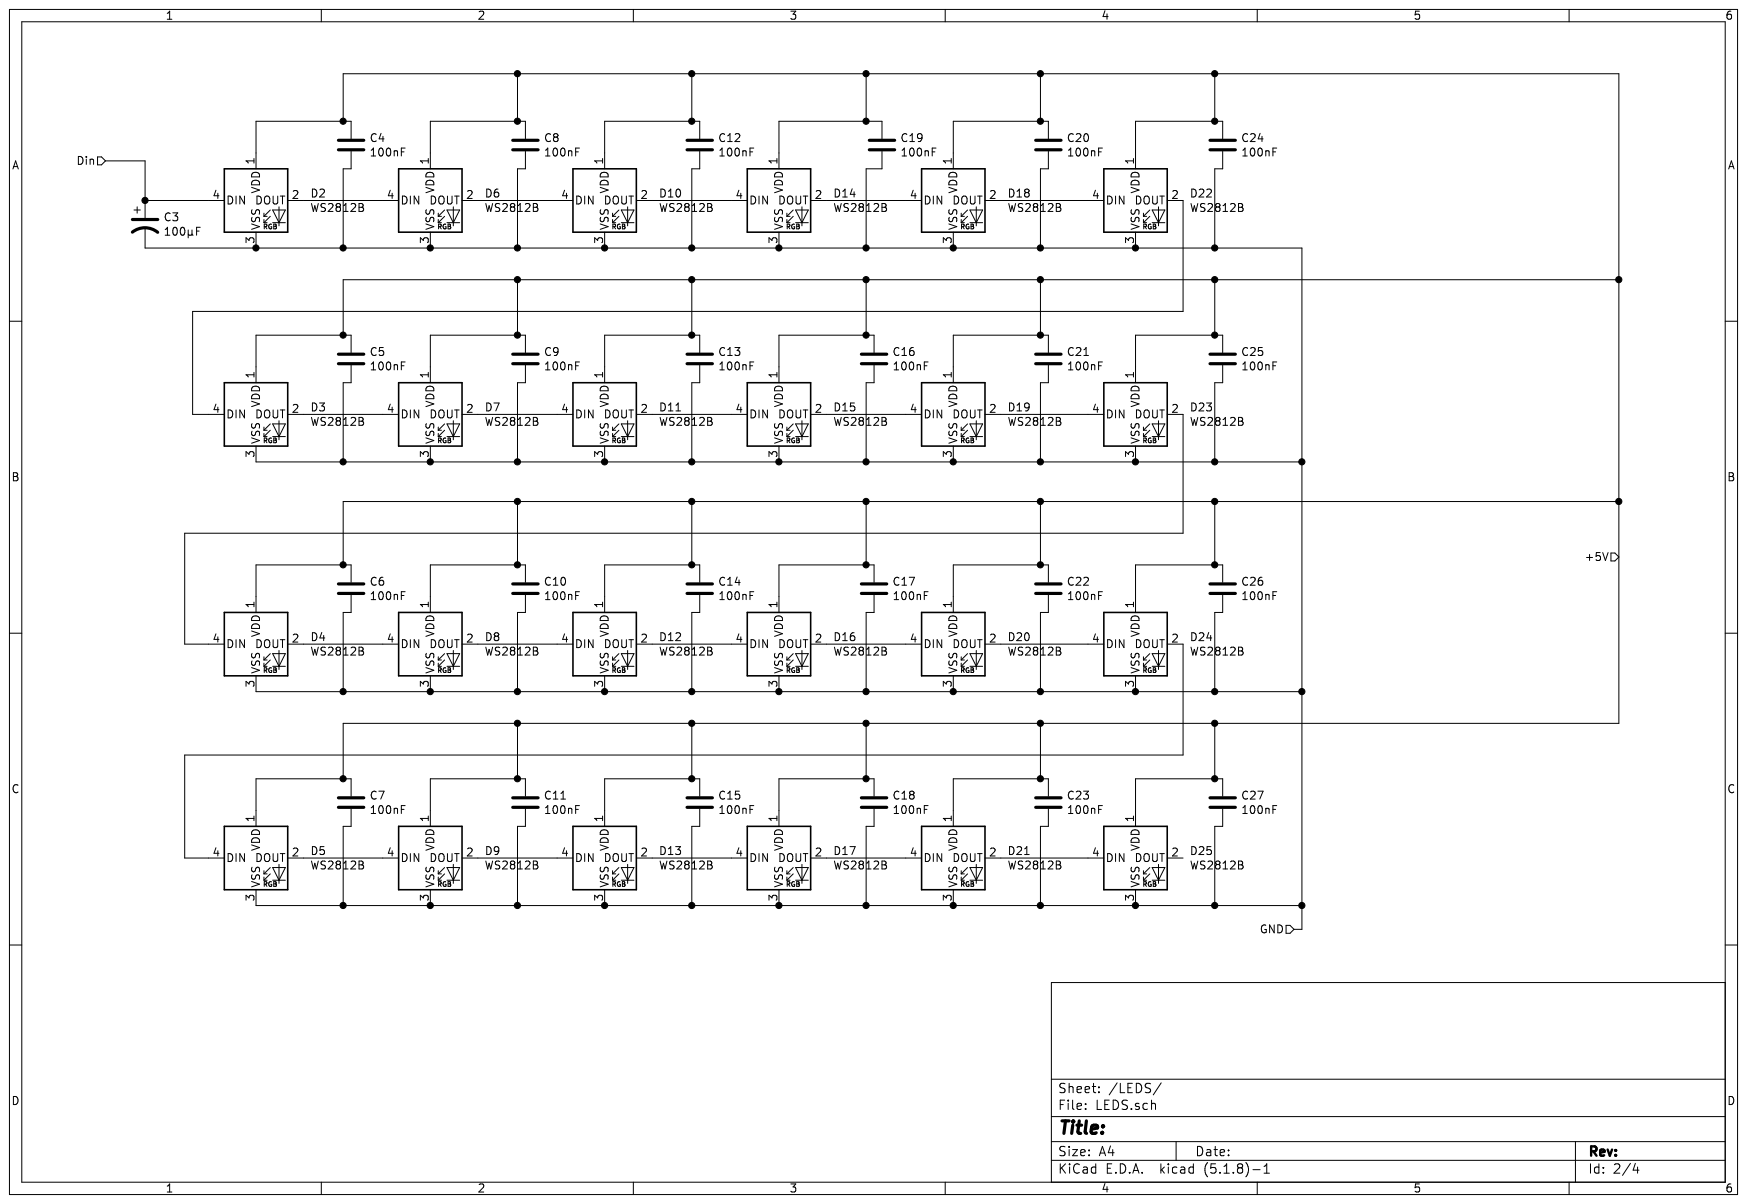
[picture p62: page 2]

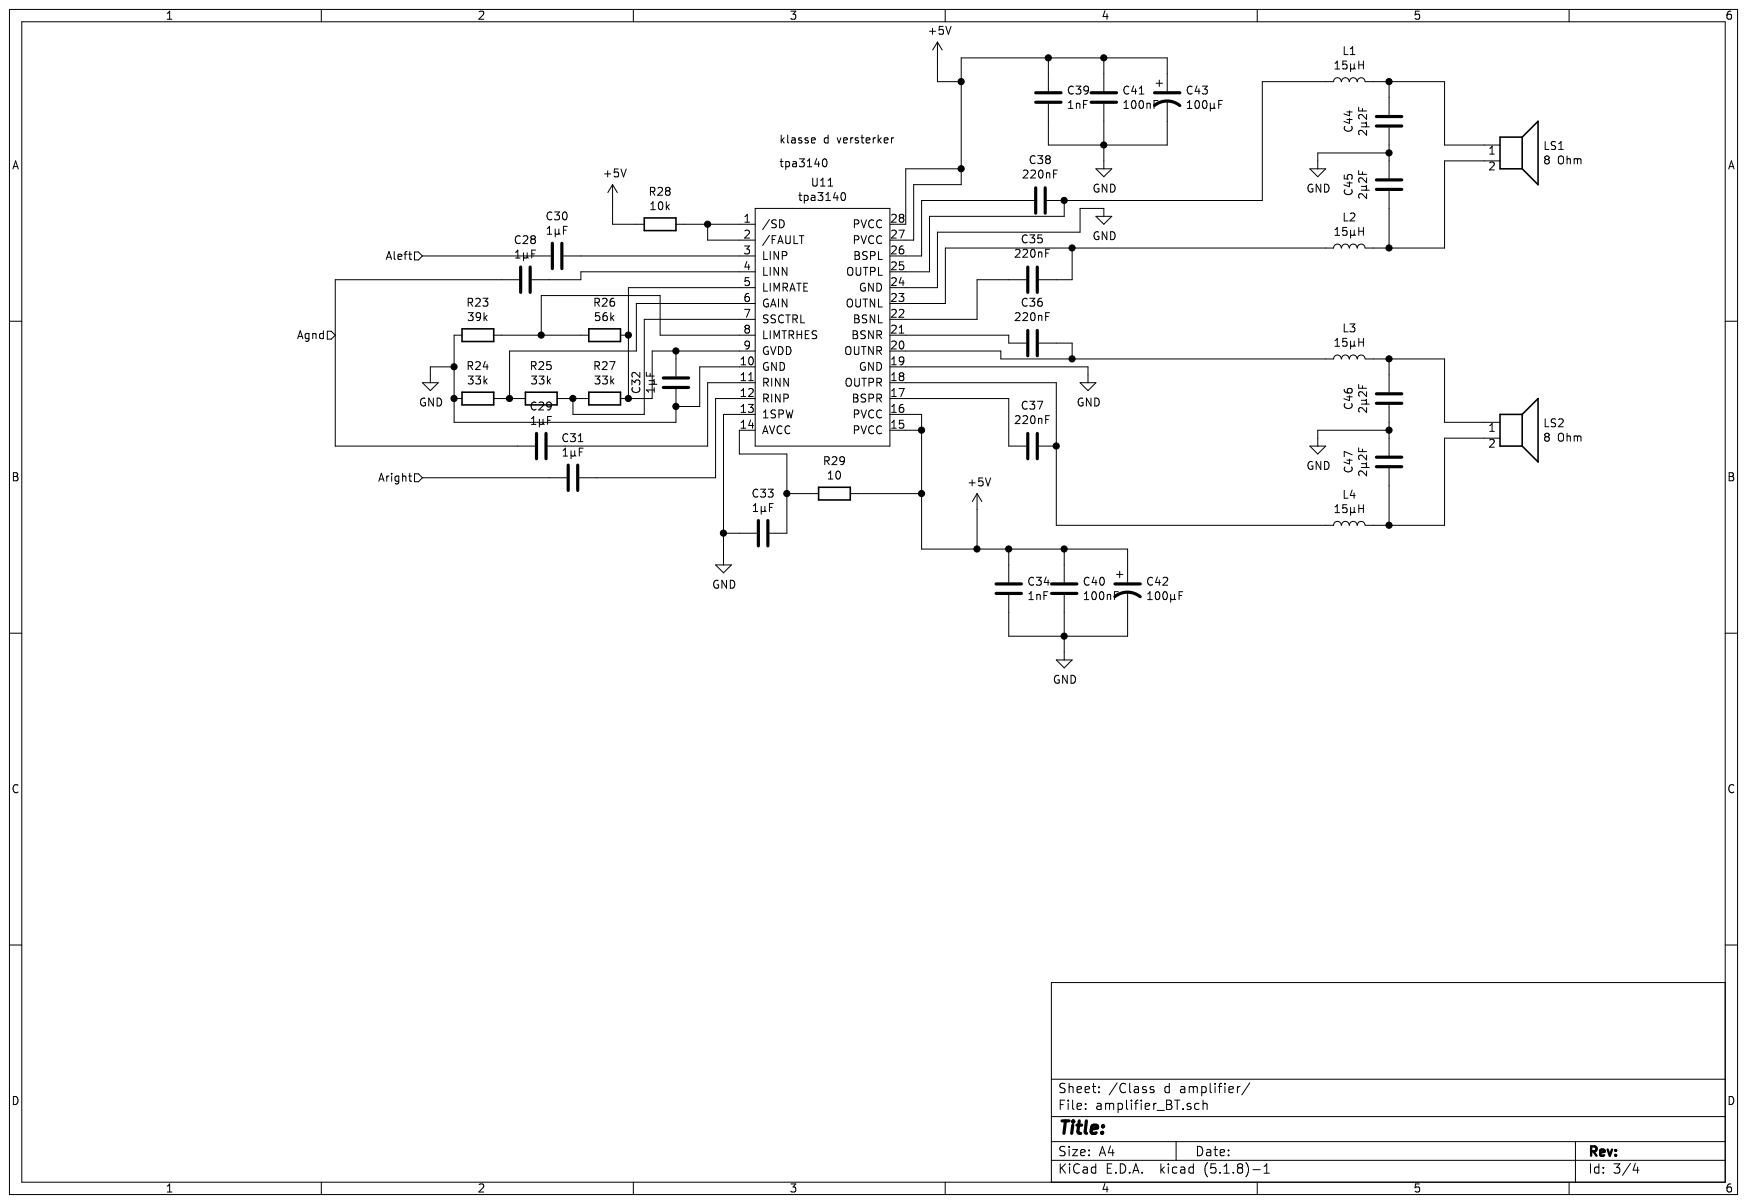
[picture p63: page 3]

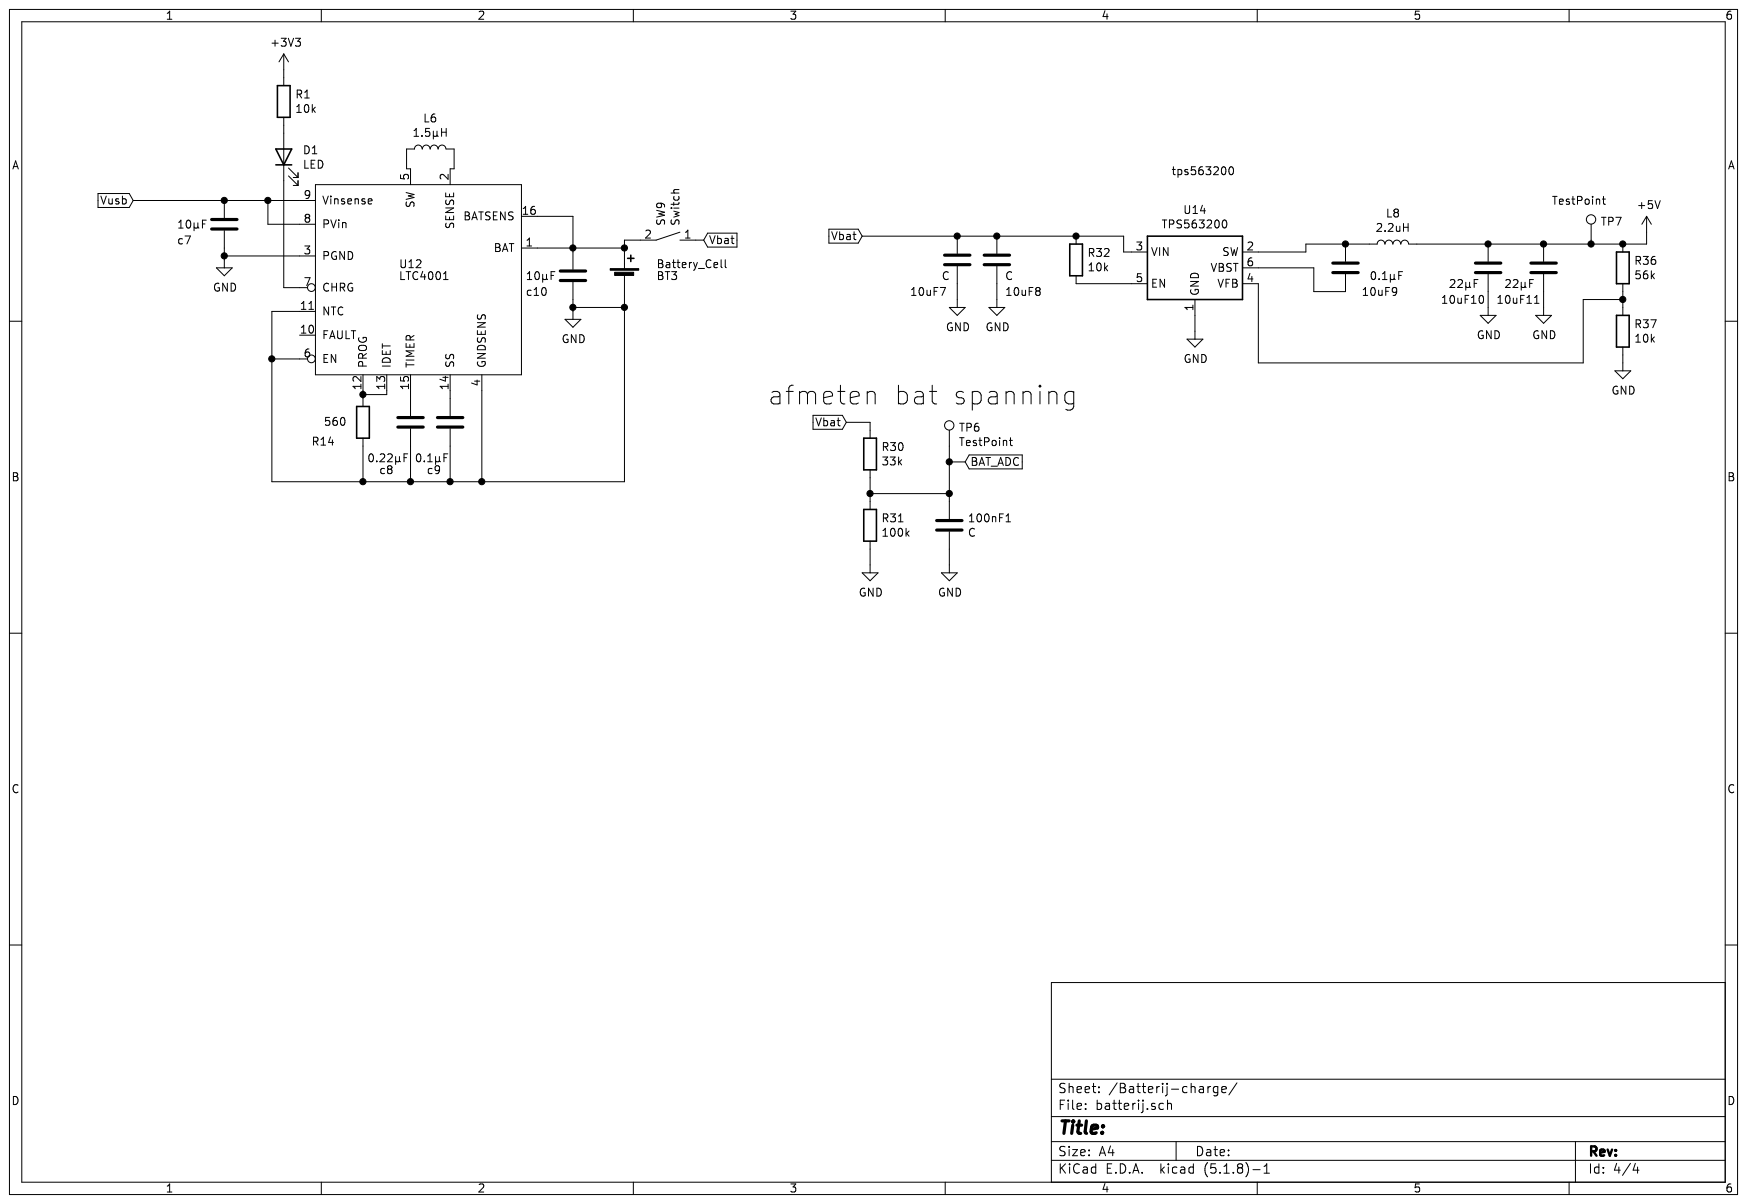
[picture p64: page 4]
