r078786/PE2_BS/Bluetooth_music_box/schema's_en_pcb/schema_v1/pcb_robbe1.pdf

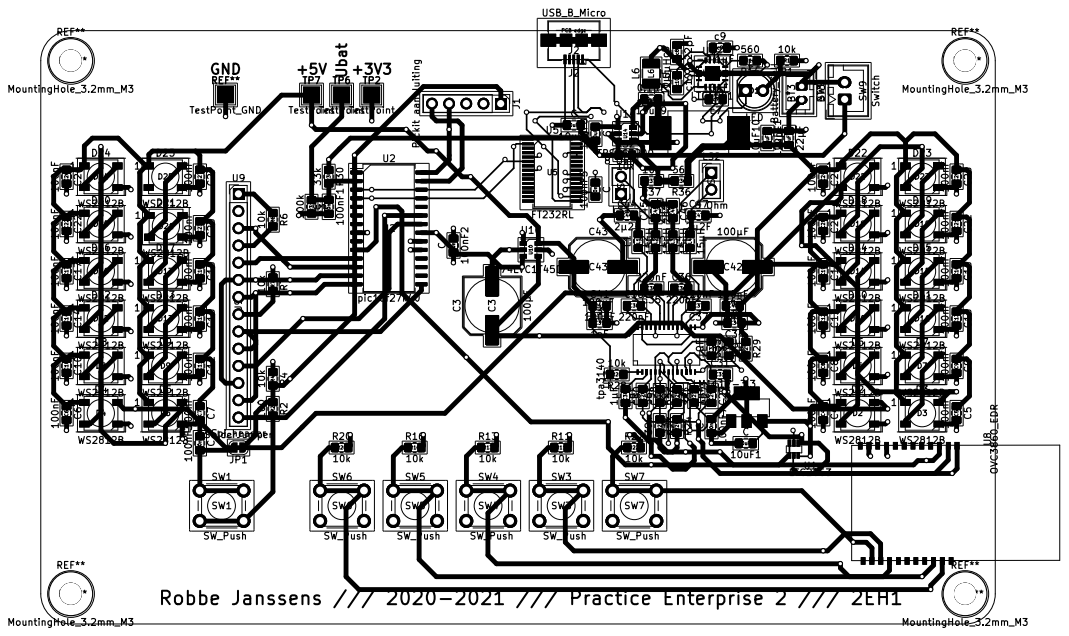
[picture p65: page 1]
