r078786/PE2_BS/Bluetooth_music_box/schema's_en_pcb/schema_v1/schema_robbe.pdf

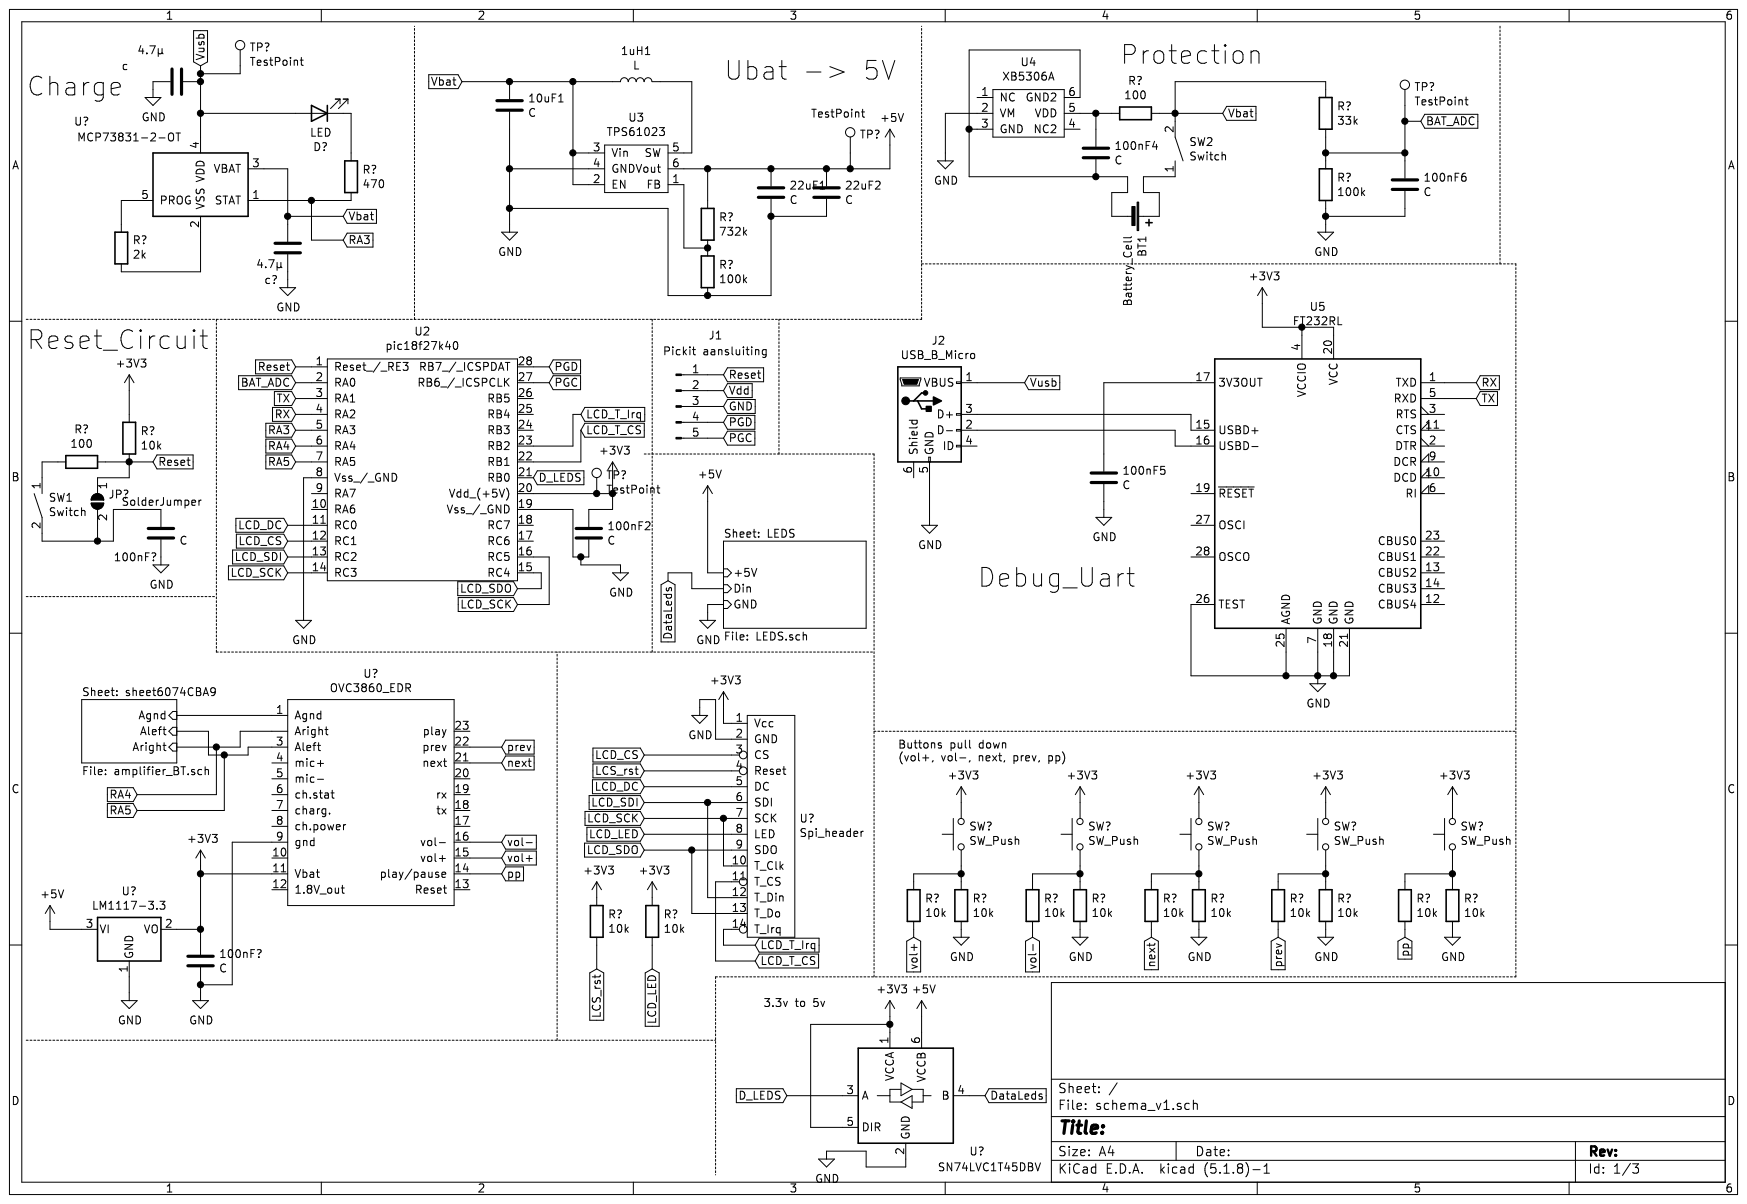
[picture p66: page 1]

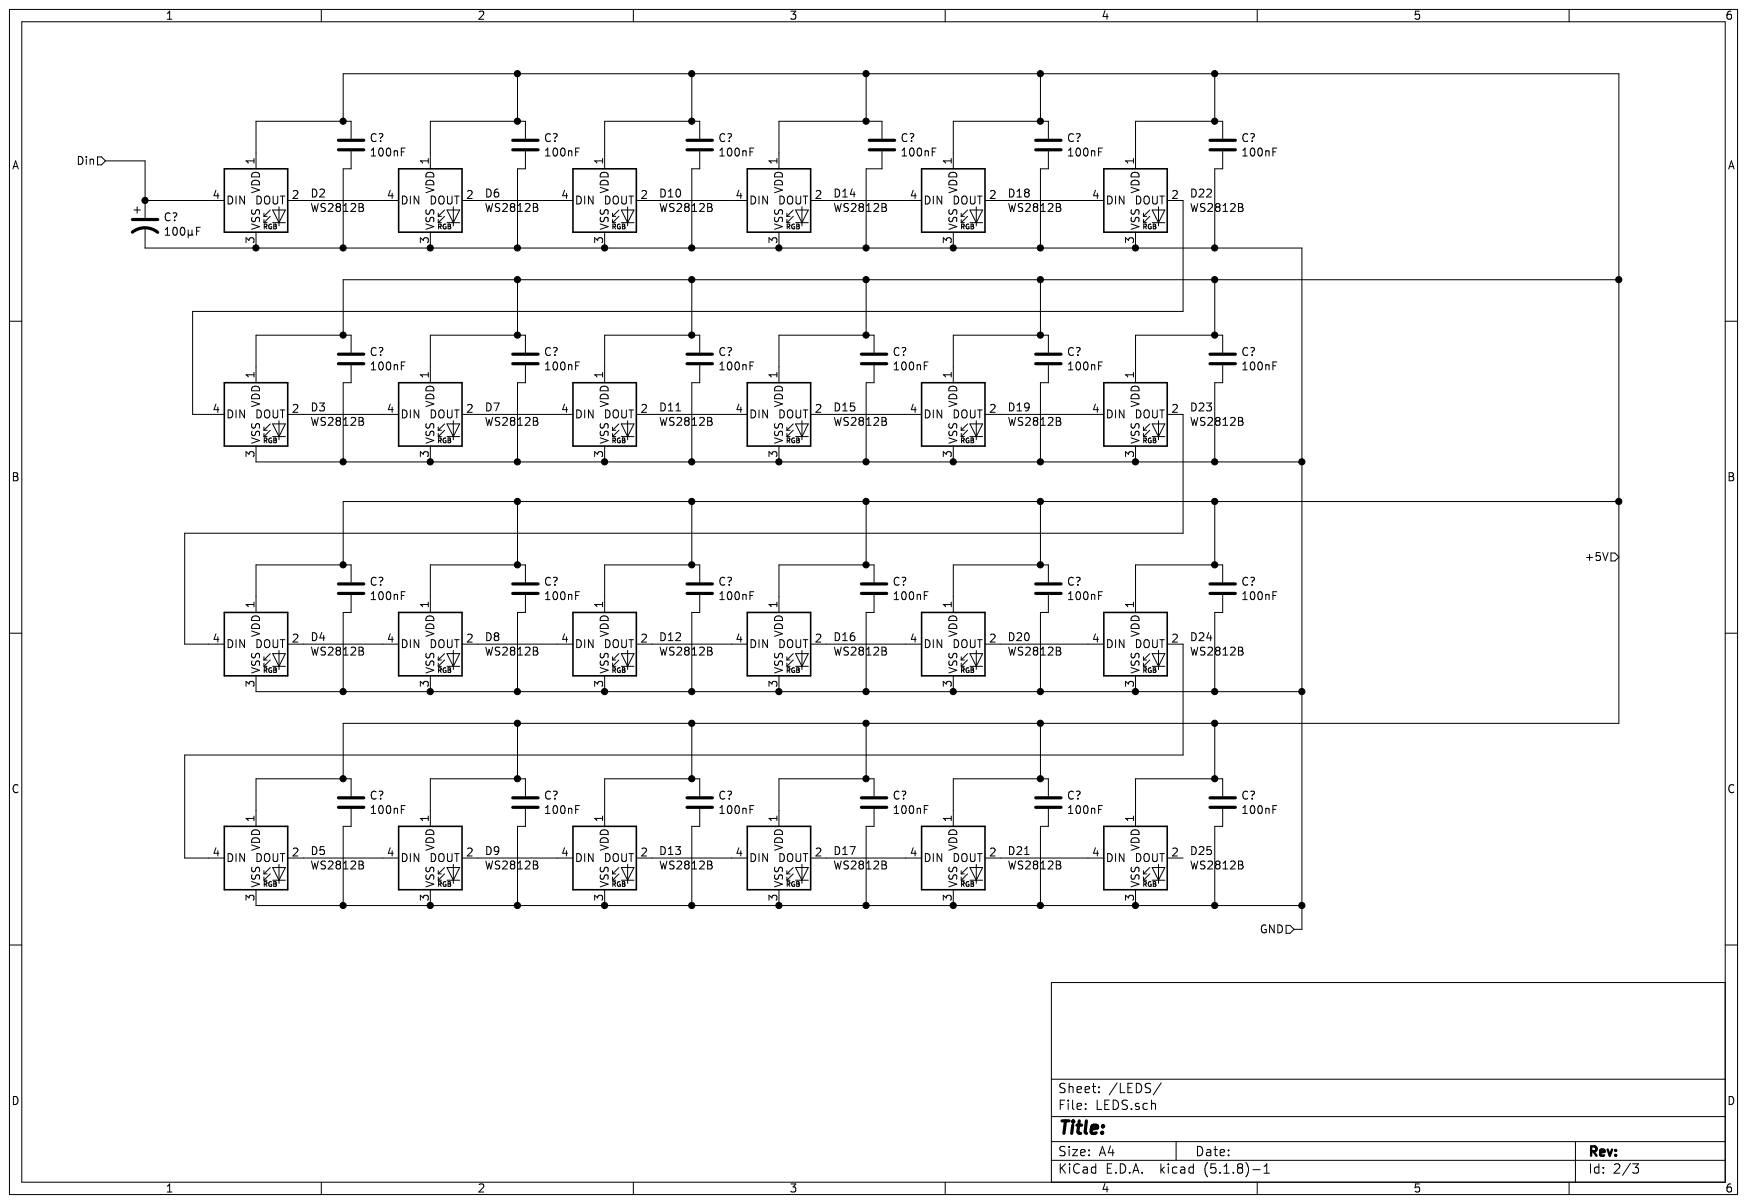
[picture p67: page 2]

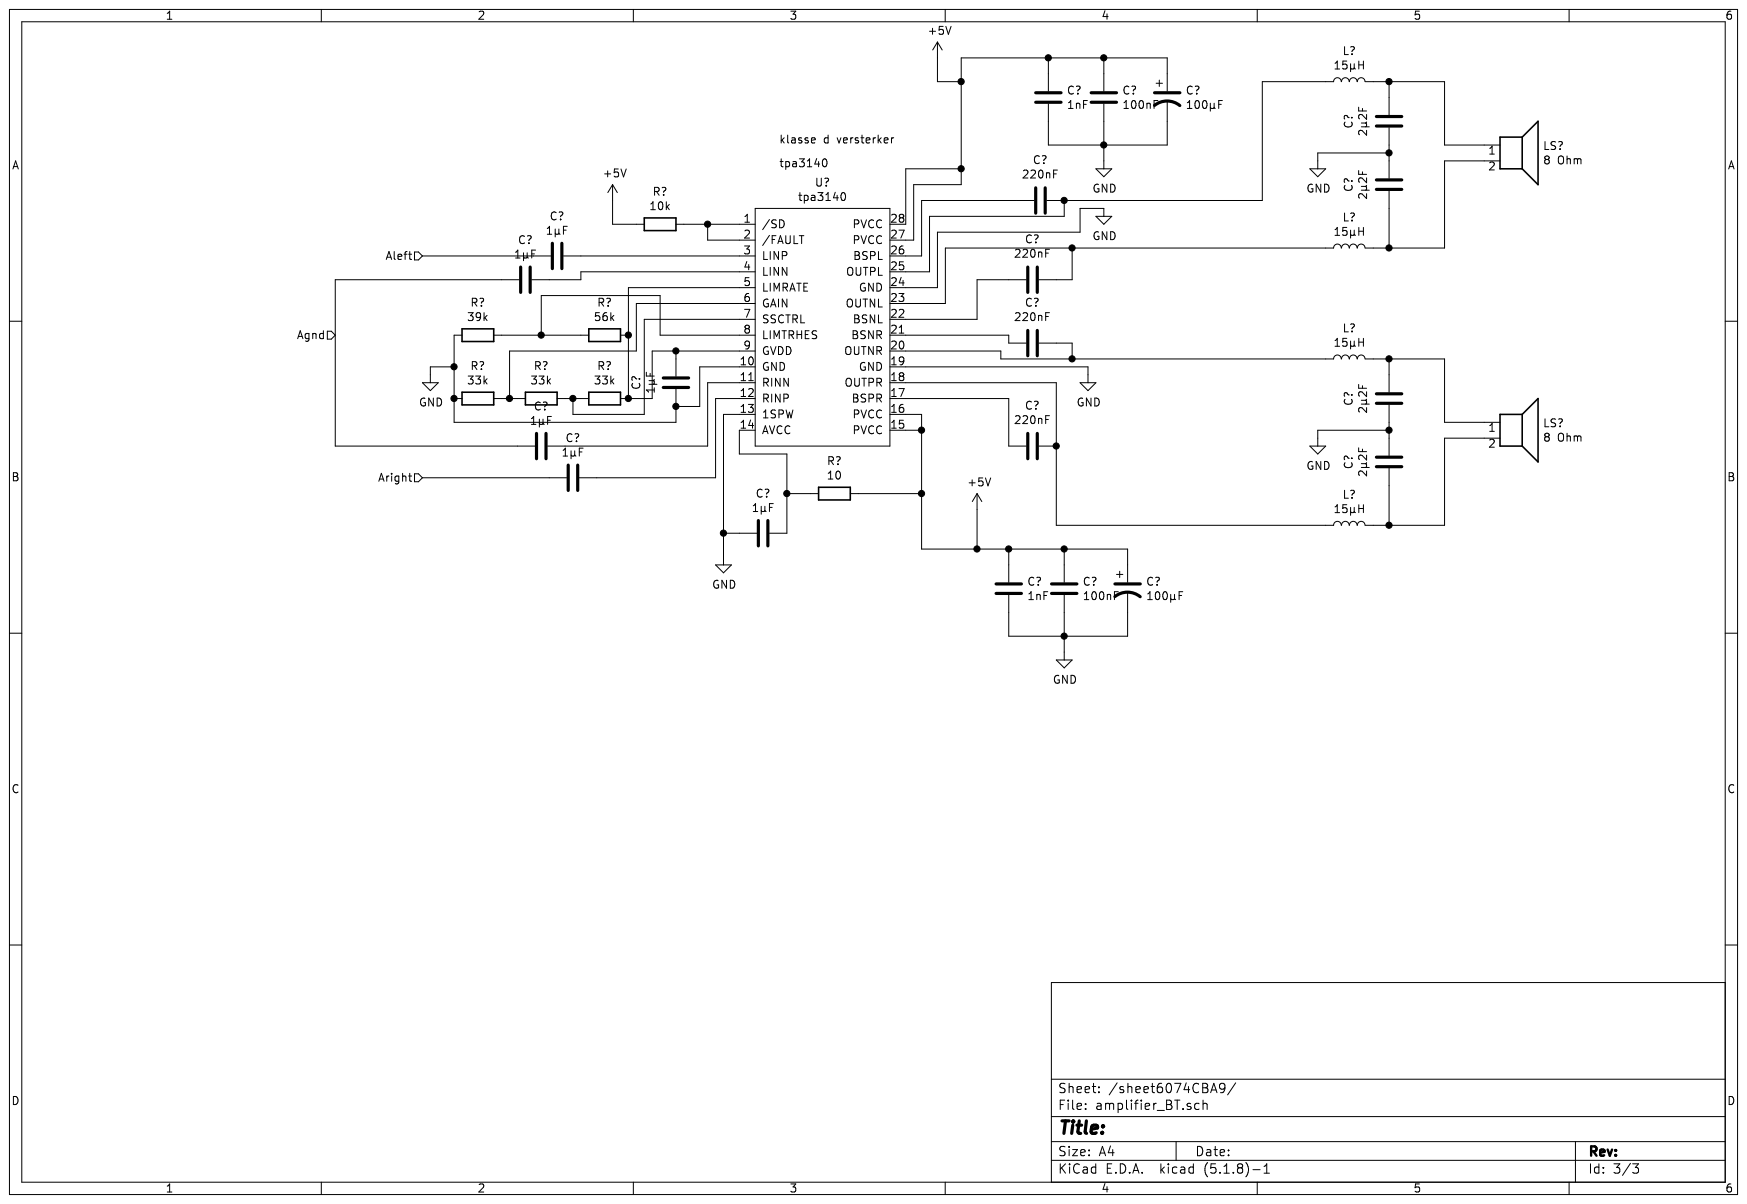
[picture p68: page 3]
