r078786/PE2_BS/Bluetooth_music_box/schema's_en_pcb/schema_v1/schema_robbe2.pdf

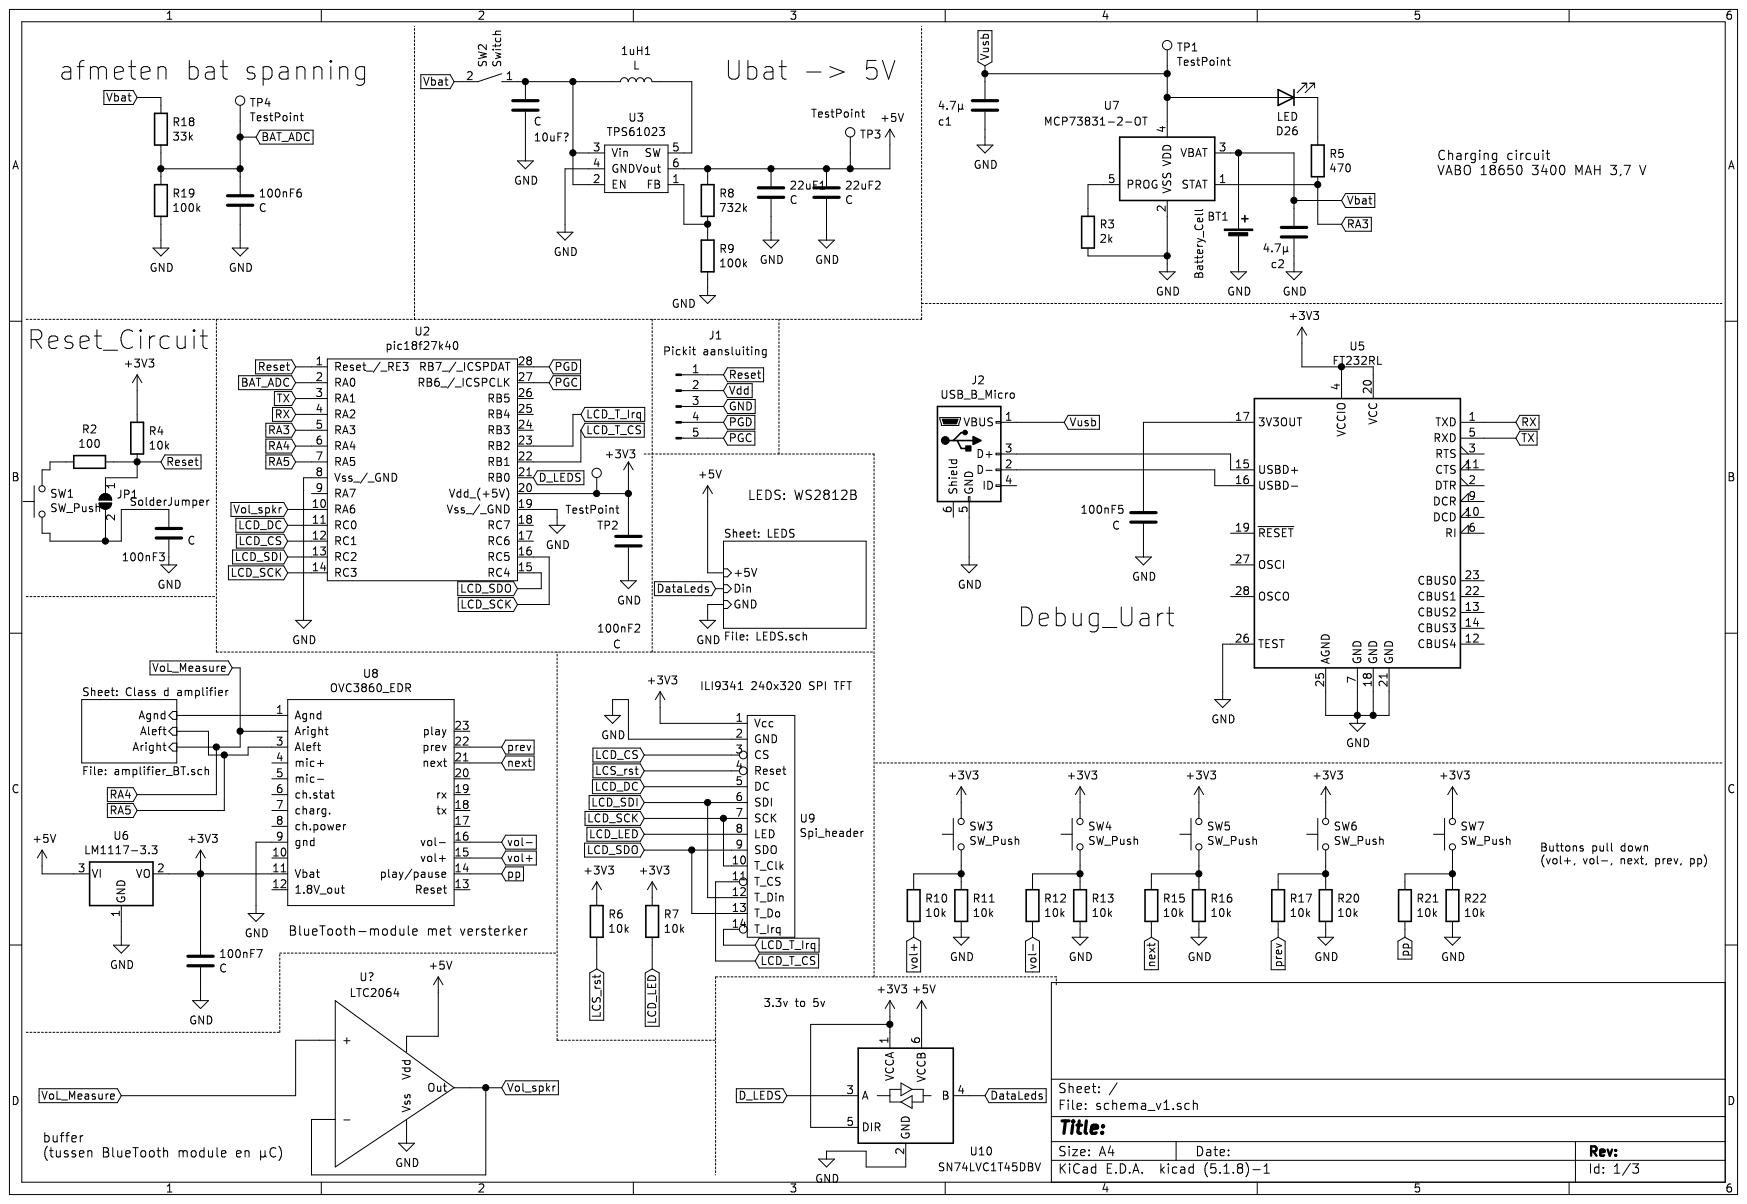
[picture p69: page 1]

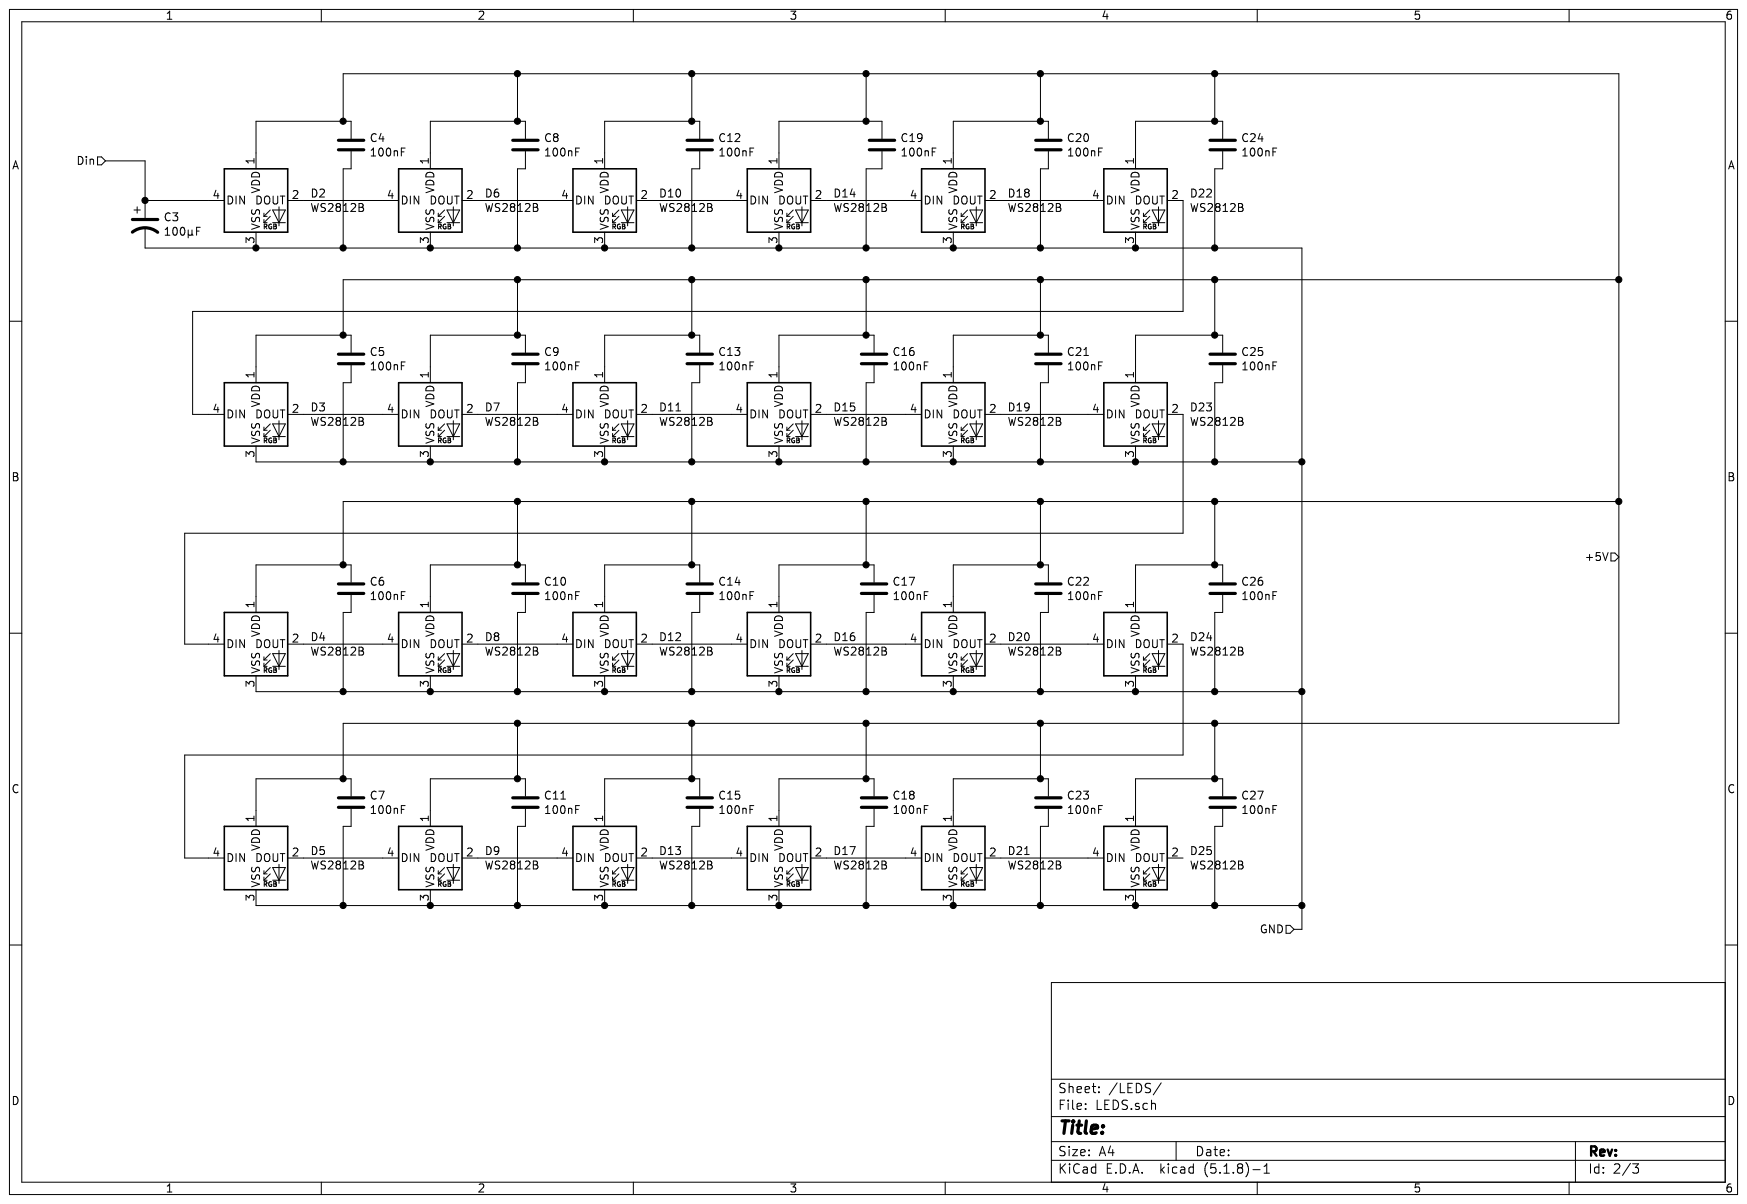
[picture p70: page 2]

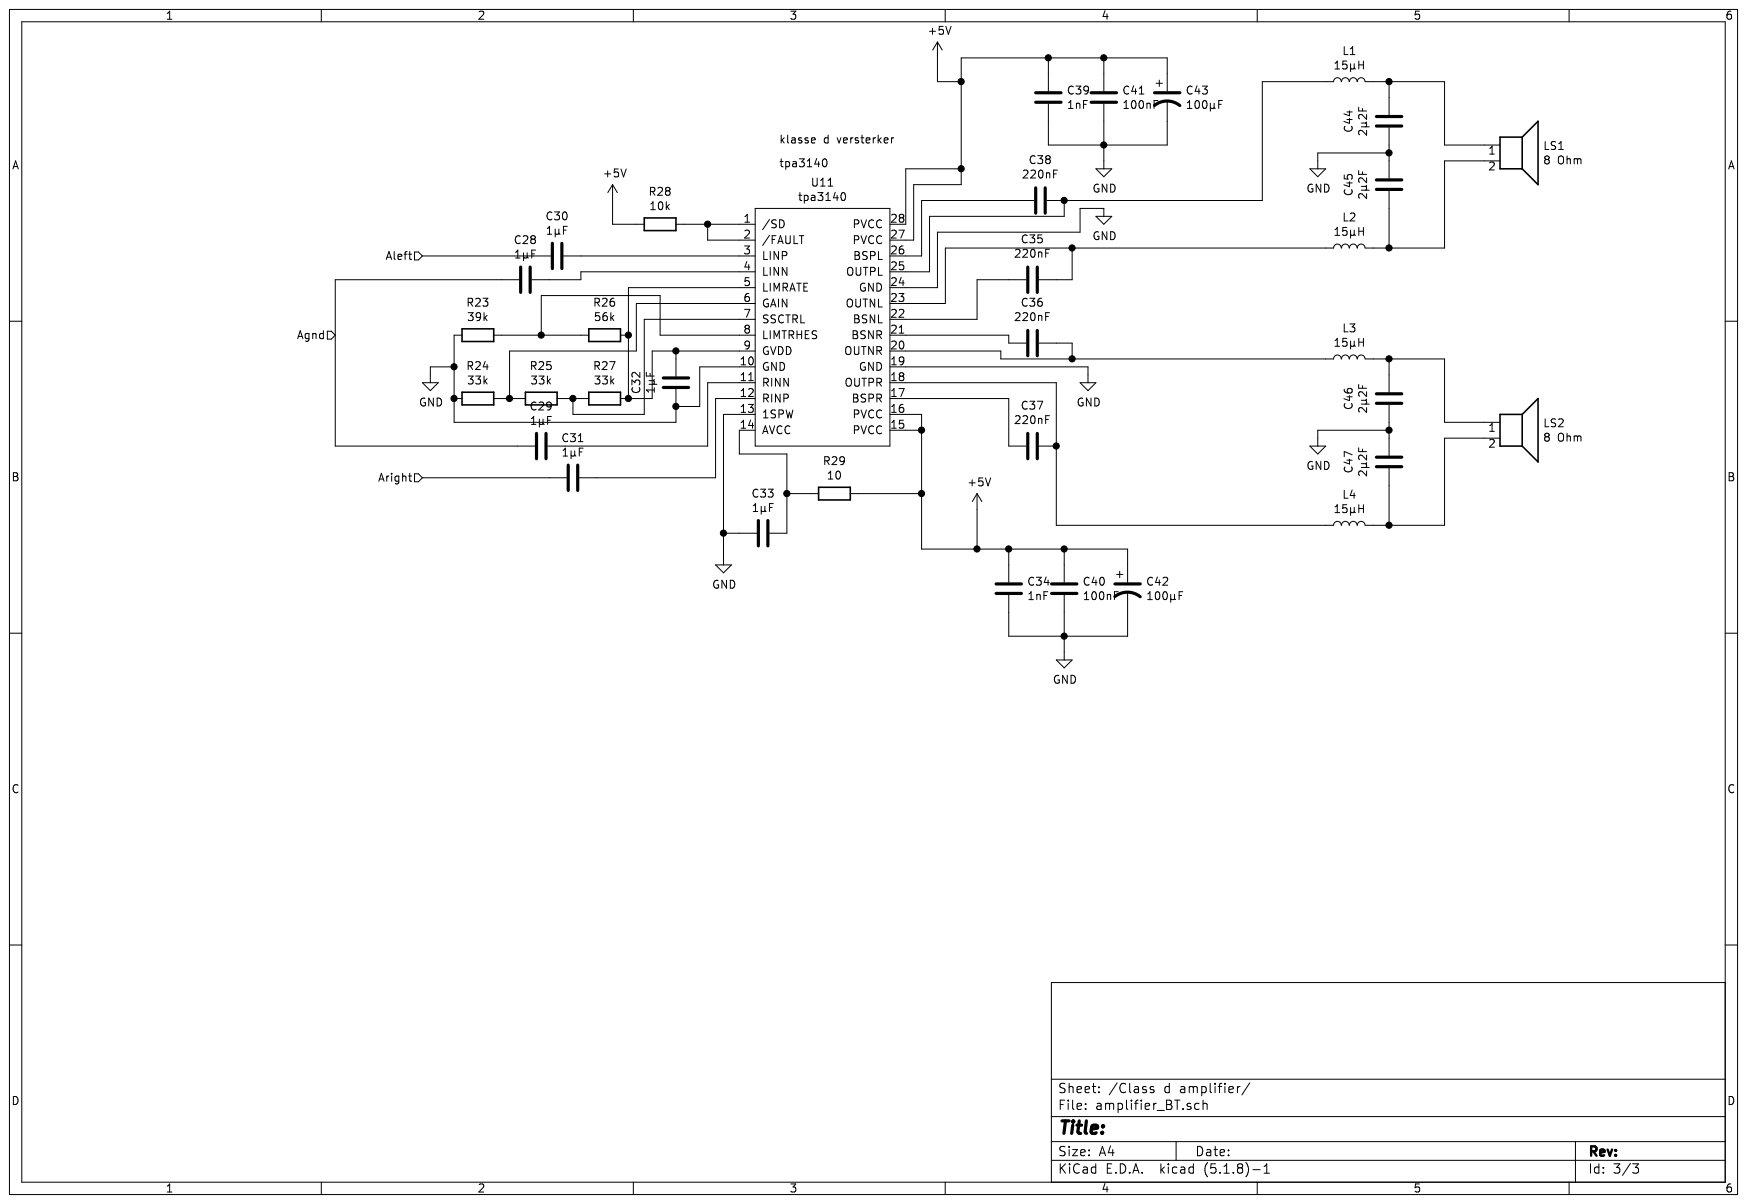
[picture p71: page 3]
