r078786/PE2_BS/Bluetooth_music_box/schema's_en_pcb/schema_v1/schema_robbe3.pdf

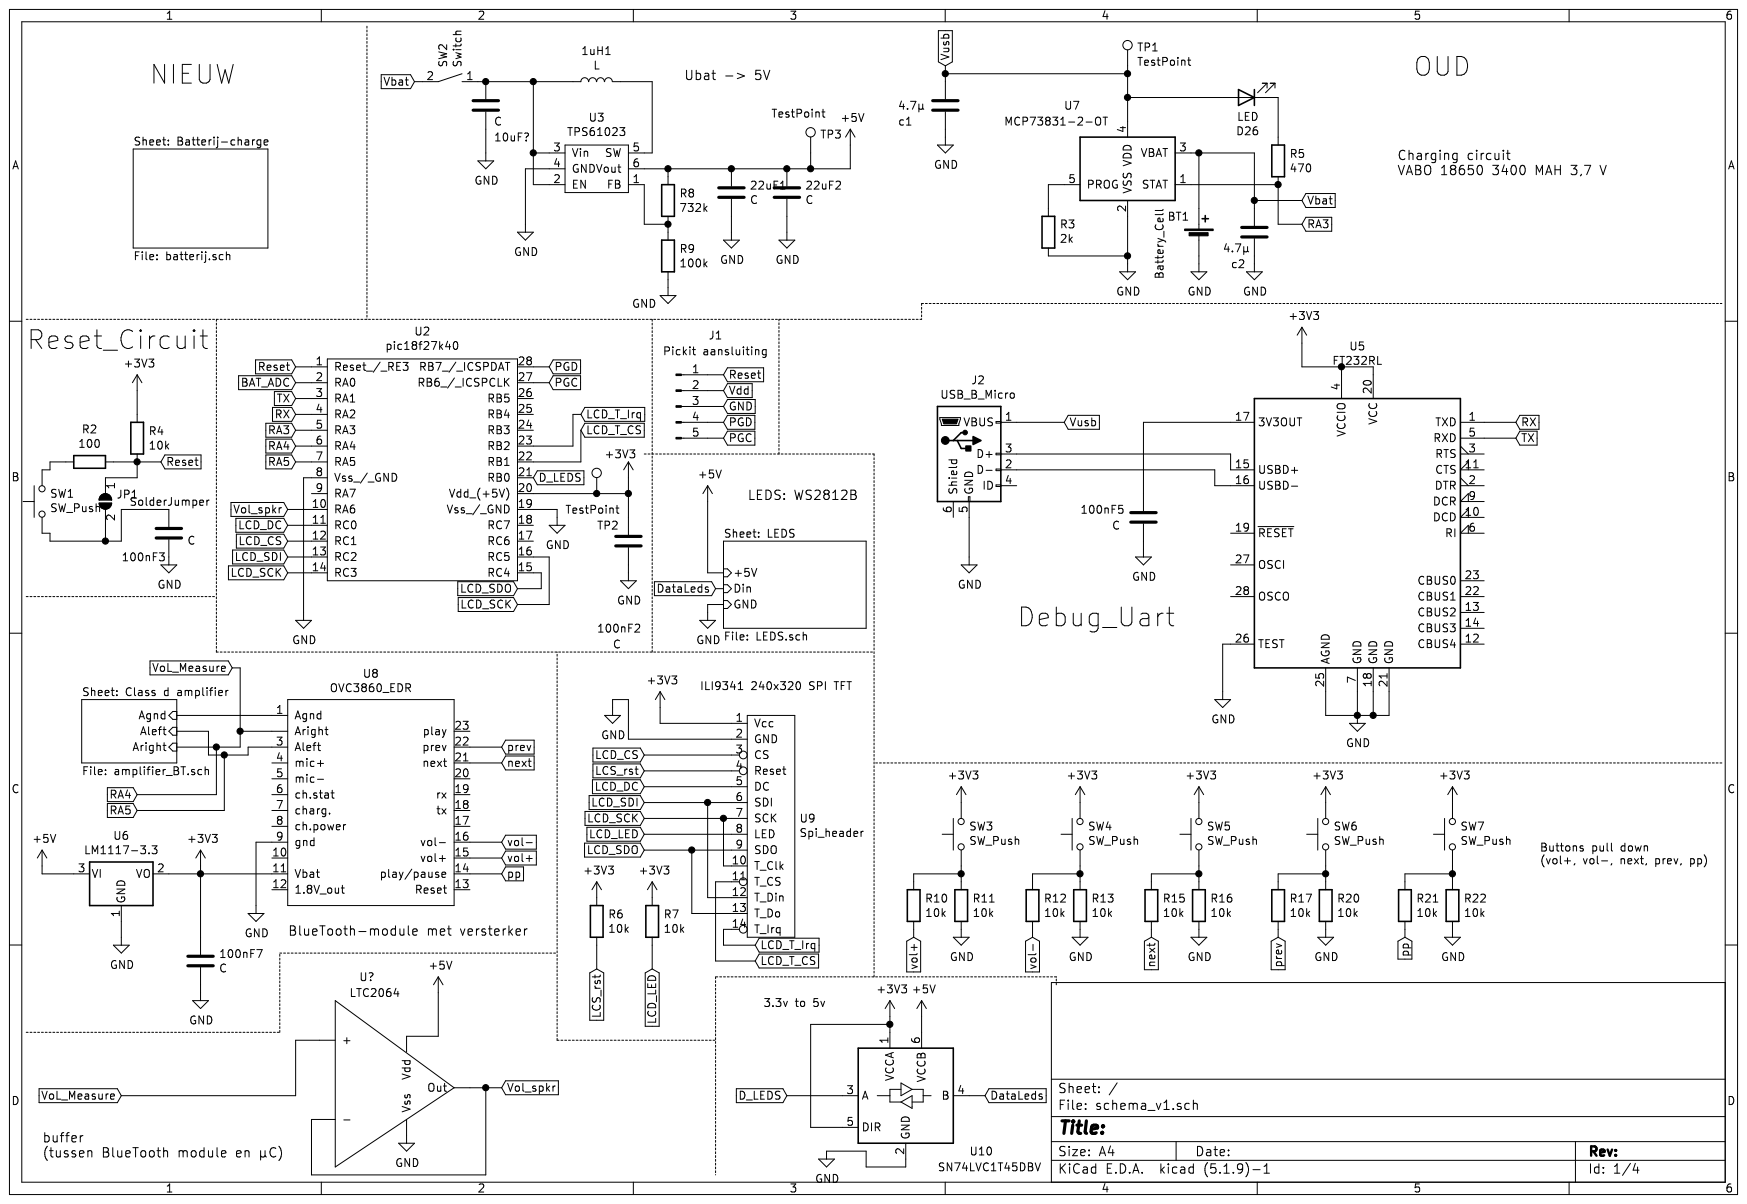
[picture p72: page 1]

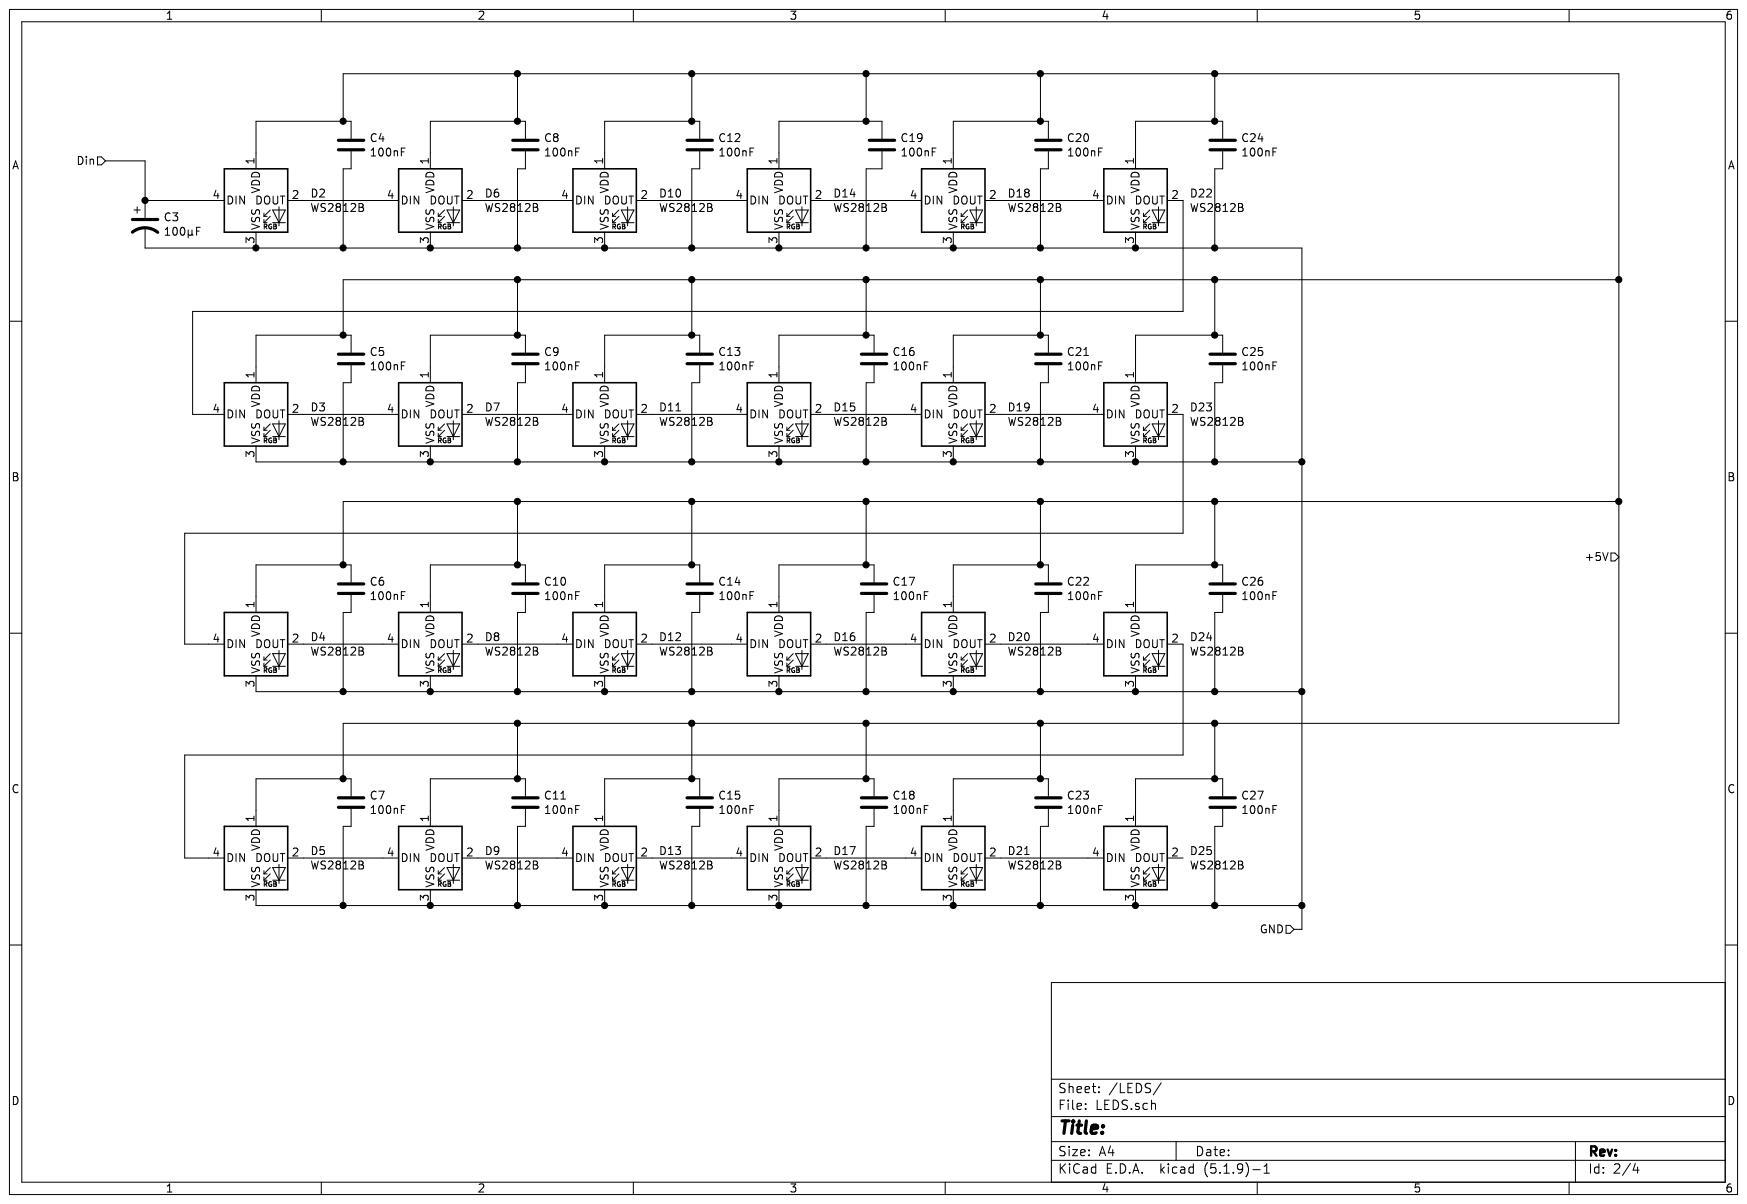
[picture p73: page 2]

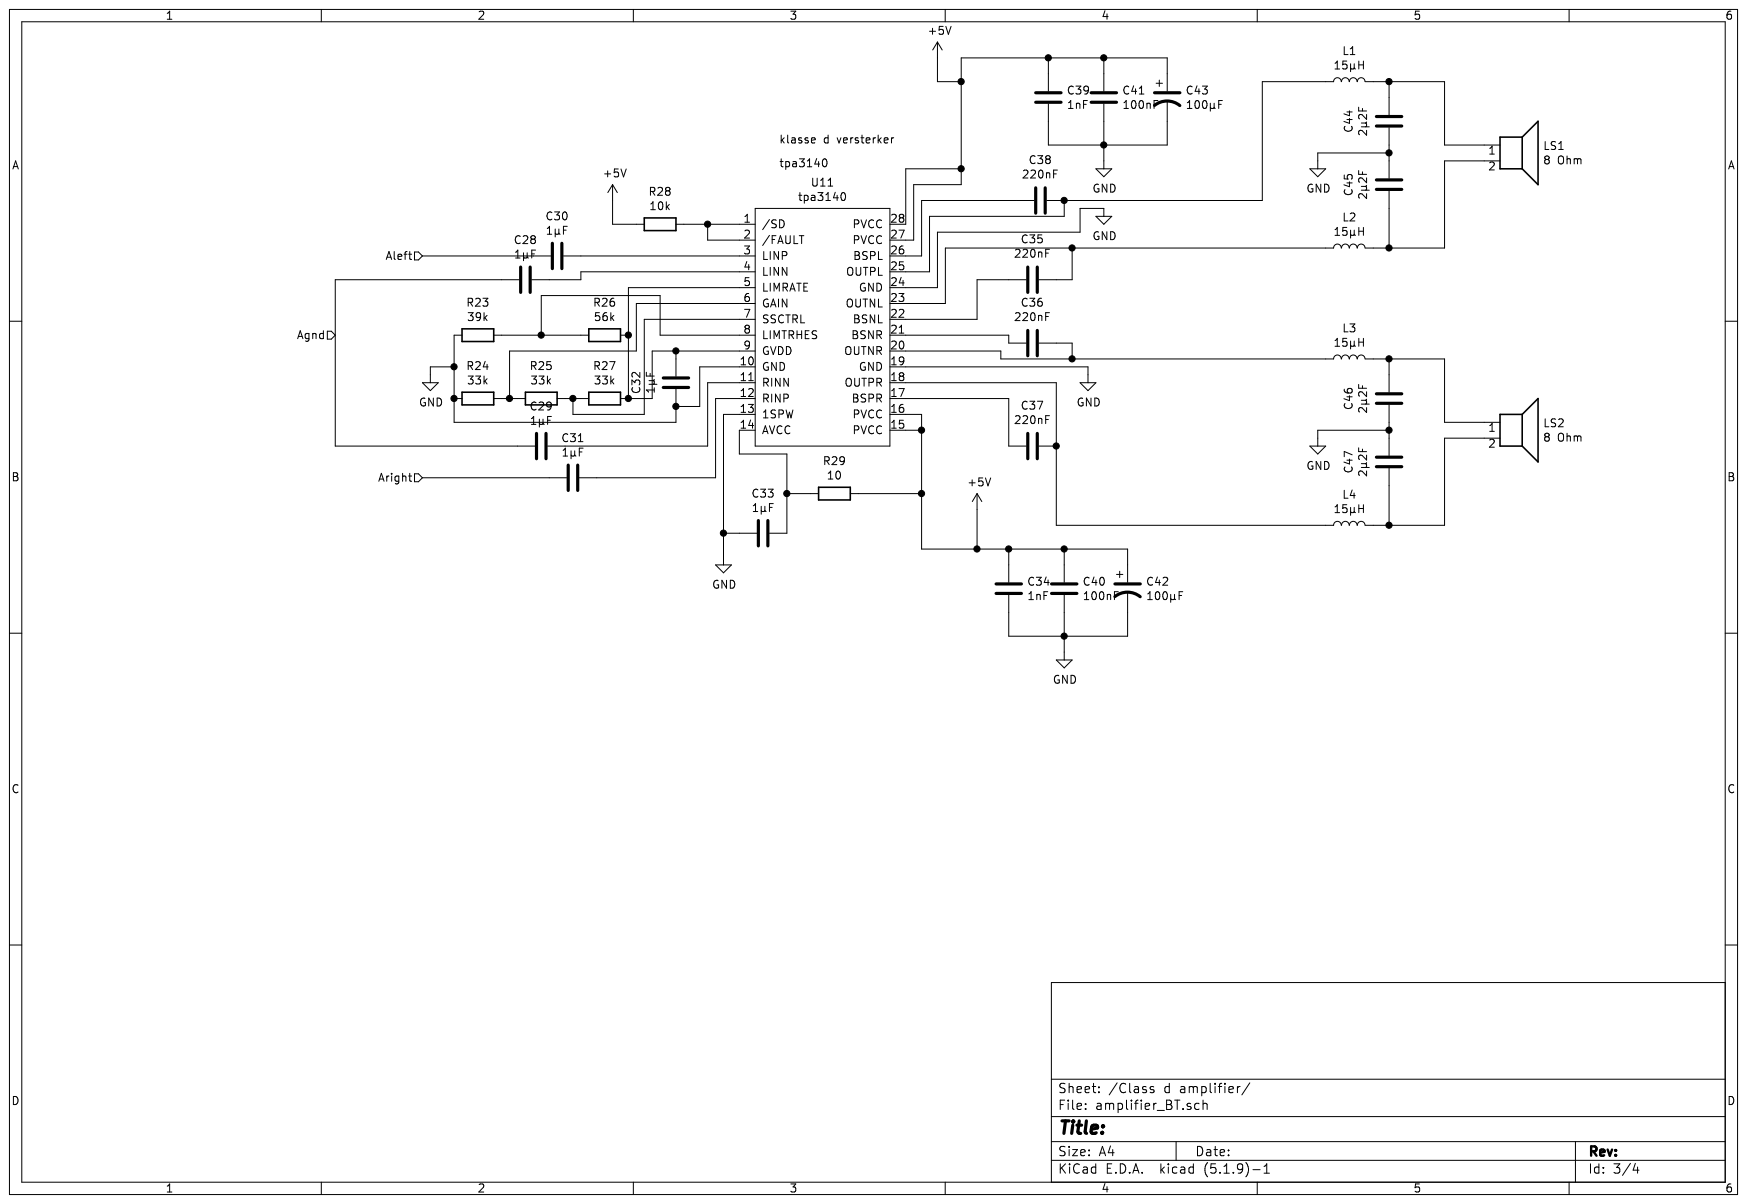
[picture p74: page 3]

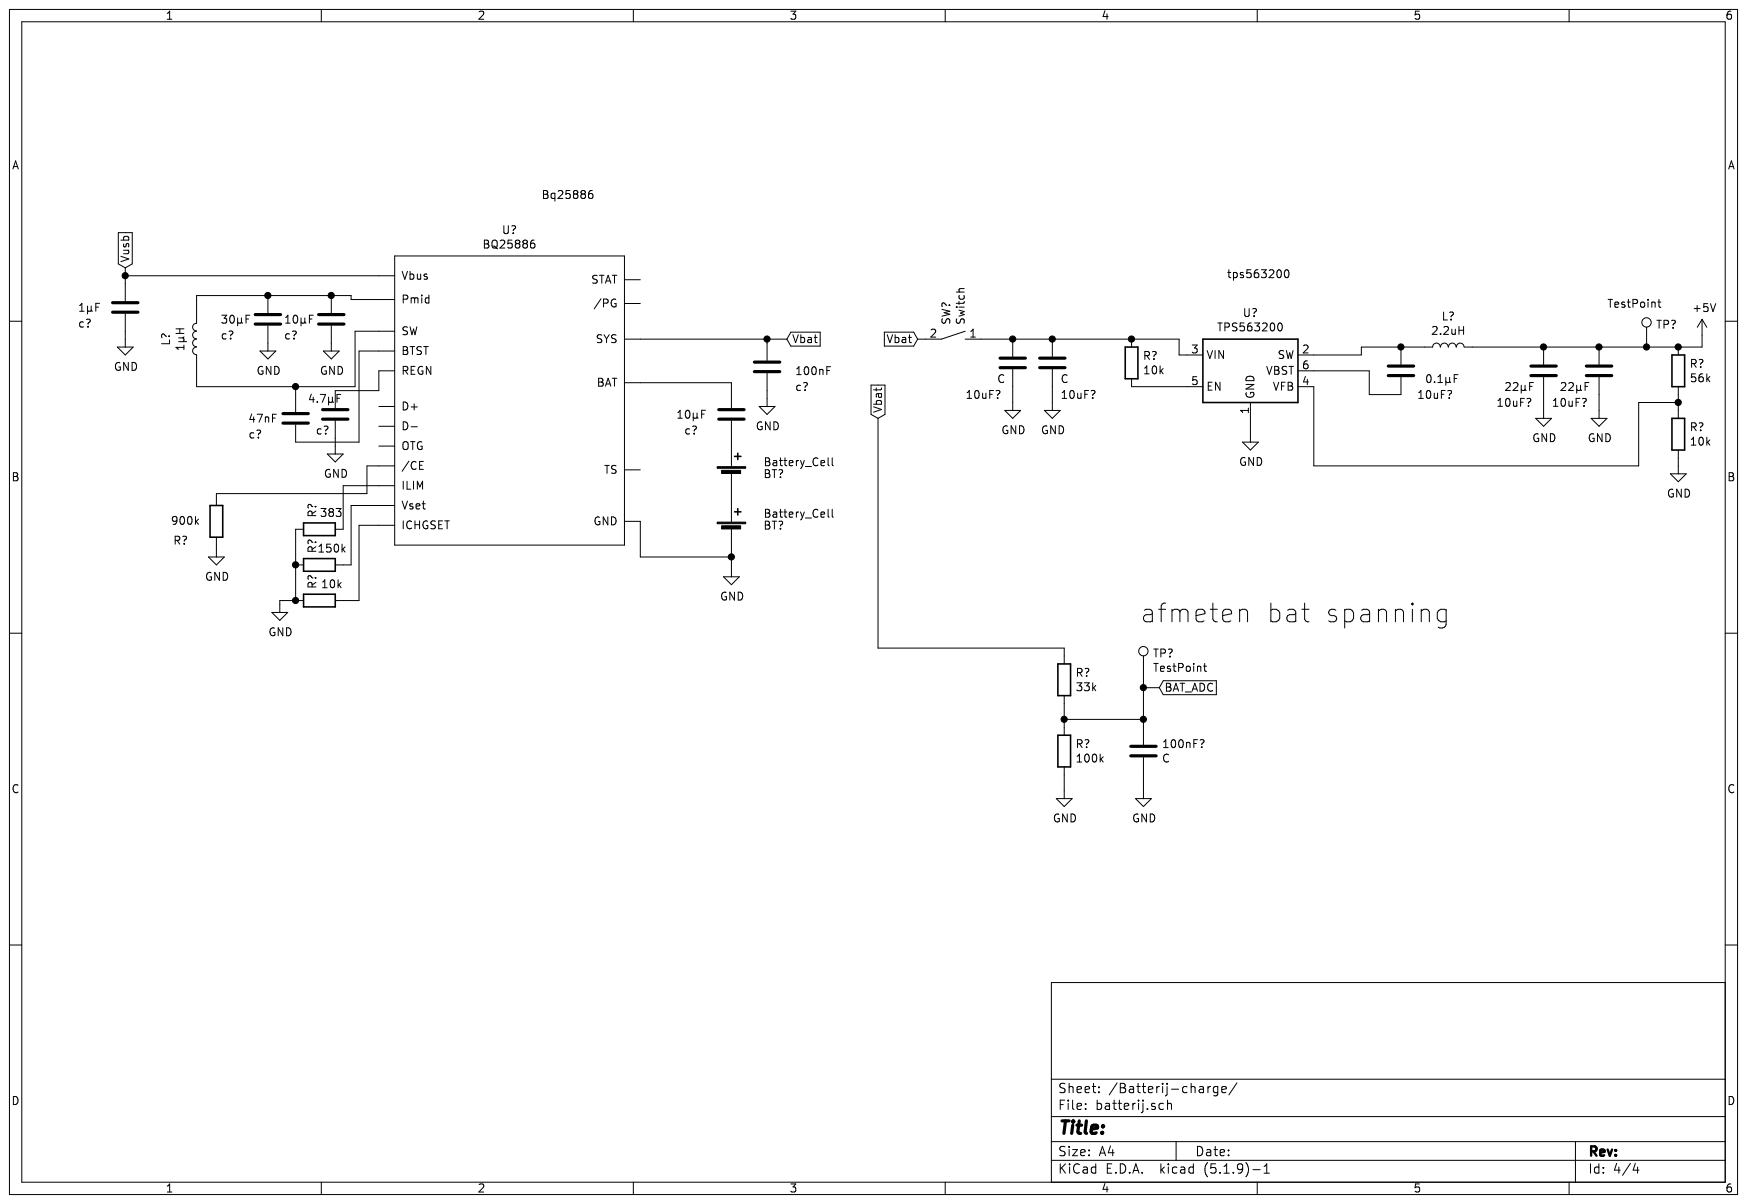
[picture p75: page 4]
