r078786/PE2_BS/Bluetooth_music_box/schema's_en_pcb/schema_v1/schema_v1.kicad_pcb

## KiCad design Bluetooth_music_box/schema's_en_pcb/schema_v1/schema_v1.kicad_pcb (2021-04-28)

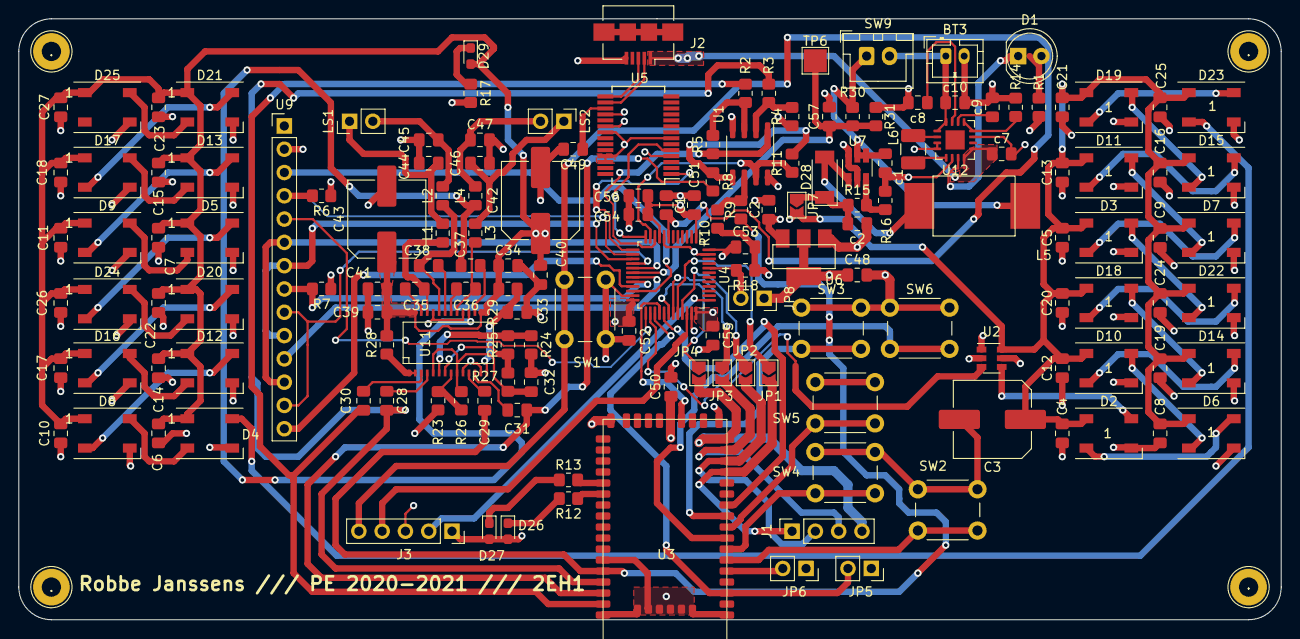
[picture p76: board schema_v1.kicad_pcb from above]

Board: 4 copper layers, 137.7 x 65.5 mm, 161 parts (0 on the bottom side), 114 nets.

Parts:
., .#2, .#3, .#4: TestPoint_THTPad_D4.0mm_Drill2.0mm
BT3: Battery_Cell; JST_PH_B2B-PH-K_1x02_P2.00mm_Vertical
C1, C4, C5, C6, C7, C8, C9, C10, C11, C12, C13, C14, C15, C16, C17, C18, C19, C20, C21, C22, C23, C24, C25, C26, C27, C40, C41, C48, C49, C51, C52, C53, C54, C55, C57: 100nF; C_0805_2012Metric_Pad1.18x1.45mm_HandSolder
C2, C50: 10uF; C_0805_2012Metric_Pad1.18x1.45mm_HandSolder
C3, C42, C43: 100µF; C_Elec_8x10.2
C28, C29, C30, C31, C32, C33: 1µF; C_0805_2012Metric_Pad1.18x1.45mm_HandSolder
C34, C39: 1nF; C_0805_2012Metric_Pad1.18x1.45mm_HandSolder
C35, C36, C37, C38: 220nF; C_0805_2012Metric_Pad1.18x1.45mm_HandSolder
C44, C45, C46, C47: 2µ2F; C_0805_2012Metric_Pad1.18x1.45mm_HandSolder
C56: 10nF; C_0805_2012Metric_Pad1.18x1.45mm_HandSolder
D1: LED; LED_D5.0mm
D2, D3, D4, D5, D6, D7, D8, D9, D10, D11, D12, D13, D14, D15, D16, D17, D18, D19, D20, D21, D22, D23, D24, D25: WS2812B; LED_WS2812B_PLCC4_5.0x5.0mm_P3.2mm
D26: BLUE; LED_0603_1608Metric_Pad1.05x0.95mm_HandSolder
D27, D29: RED; LED_0603_1608Metric_Pad1.05x0.95mm_HandSolder
D28: D_Schottky; D_SOD-128
J1: Conn_01x04; PinSocket_1x04_P2.54mm_Vertical
J2: USB_B_Micro; USB_Micro-B_Amphenol_10104110_Horizontal
J3: Conn_01x05_Male; PinSocket_1x05_P2.54mm_Vertical
JP1, JP2, JP3, JP4, JP7: SolderJumper; SolderJumper-2_P1.3mm_Open_TrianglePad1.0x1.5mm
JP5, JP6, JP8: Jumper; PinSocket_1x02_P2.54mm_Vertical
L1, L2, L3, L4: 15µH; L_0805_2012Metric_Pad1.15x1.40mm_HandSolder
L5: 2.2uH; L_tps563200
L6: 1.5µH; L_1210_3225Metric_Pad1.42x2.65mm_HandSolder
LS1, LS2: 8 Ohm; PinHeader_1x02_P2.54mm_Vertical
R1: 1k; R_0805_2012Metric_Pad1.20x1.40mm_HandSolder
R2, R3, R8, R9: 100K; R_0805_2012Metric_Pad1.20x1.40mm_HandSolder
R4, R5, R10, R11: 220K; R_0805_2012Metric_Pad1.20x1.40mm_HandSolder
R6, R7, R28: 10k; R_0805_2012Metric_Pad1.20x1.40mm_HandSolder
R12, R13, R17: 100; R_0805_2012Metric_Pad1.20x1.40mm_HandSolder
R14: 560; R_0805_2012Metric_Pad1.20x1.40mm_HandSolder
R15: 562K; R_0805_2012Metric_Pad1.20x1.40mm_HandSolder
R16: 107K; R_0805_2012Metric_Pad1.20x1.40mm_HandSolder
R18: 10K; R_0805_2012Metric_Pad1.20x1.40mm_HandSolder
R23: 39k; R_0805_2012Metric_Pad1.20x1.40mm_HandSolder
R24, R25, R27, R30: 33k; R_0805_2012Metric_Pad1.20x1.40mm_HandSolder
R26: 56k; R_0805_2012Metric_Pad1.20x1.40mm_HandSolder
R29: 10; R_0805_2012Metric_Pad1.20x1.40mm_HandSolder
R31: 100k; R_0805_2012Metric_Pad1.20x1.40mm_HandSolder
SW1, SW2, SW3, SW4, SW5, SW6: SW_Push; SW_PUSH_6mm_H7.3mm
SW9: Switch; JST_XH_B2B-XH-A_1x02_P2.50mm_Vertical
TP6: TestPoint; TestPoint_Pad_2.5x2.5mm
U1: TL072; SO-8_3.9x4.9mm_P1.27mm
U2: SN74LVC1T45DBV; SOT-23-6
U3: RN52
U4: STM32L443CCTx; LQFP-48_7x7mm_P0.5mm
U5: FT232RL; SSOP-28_5.3x10.2mm_P0.65mm
U6: LM1117-3.3; LM1117
U7: TLV61048; SOT-23-6_Handsoldering
U9: Spi_header; PinHeader_1x14_P2.54mm_Vertical
U11: tpa3140
U12: LTC4001; QFN-16-1EP_4x4mm_P0.65mm_EP2.1x2.1mm
c1: 1uF; C_0805_2012Metric_Pad1.18x1.45mm_HandSolder
c2, c7, c10: 10µF; C_0805_2012Metric_Pad1.18x1.45mm_HandSolder
c8: 0.22µF; C_0805_2012Metric_Pad1.18x1.45mm_HandSolder
c9: 0.1µF; C_0805_2012Metric_Pad1.18x1.45mm_HandSolder

Connections:
+3V3: C48.1, C50.1, C51.1, C52.1, C53.1, C54.1, C55.1, C56.1, D26.2, D27.2, J3.1, JP5.1, JP6.1, JP8.1, R1.1, R6.1, R7.1, U1.8, U2.1, U2.5, U3.22, U4.1, U4.9, U4.24, U4.36, U4.48, U5.4, U5.20, U6.2, U9.1
+5V: C2.1, C3.1, C4.1, C5.1, C6.1, C7.1, C8.1, C9.1, C10.1, C11.1, C12.1, C13.1, C14.1, C15.1, C16.1, C17.1, C18.1, C19.1, C20.1, C21.1, C22.1, C23.1, C24.1, C25.1, C26.1, C27.1, C34.1, C39.1, C40.1, C41.1, C42.1, C43.1, D2.1, D3.1, D4.1, D5.1, D6.1, D7.1, D8.1, D9.1, D10.1, D11.1, D12.1, D13.1, D14.1, D15.1, D16.1, D17.1, D18.1, D19.1, D20.1, D21.1, D22.1, D23.1, D24.1, D25.1, D29.2, JP7.2, R28.2, R29.1, U2.6, U6.3, U11.15, U11.16, U11.27, U11.28
/BT_Audio/FACT_RESET: JP6.2, U3.5
/L+: C30.2, R2.2, U3.43
/L-: C28.2, R3.2, U3.41
/LEDS/FirstLED: D2.4, U2.4
/L_SE: R5.1, U1.1, U4.10
/R+: C31.2, R8.2, U3.42
/R-: C29.2, R9.2, U3.40
/R_SE: R11.1, U1.7, U4.11
/STM32G0/SWDCLK: J3.2, U4.37
/STM32G0/SWDIO: J3.4, U4.34
/WS2812: U2.3, U4.26
BAT_ADC: C57.1, R30.2, R31.1, TP6.1, U4.18
CTS_BT: JP2.1, U4.33
EVENT: JP5.2, U3.3, U4.27
GND: BT3.2, C1.1, C2.2, C3.2, C4.2, C5.2, C6.2, C7.2, C8.2, C9.2, C10.2, C11.2, C12.2, C13.2, C14.2, C15.2, C16.2, C17.2, C18.2, C19.2, C20.2, C21.2, C22.2, C23.2, C24.2, C25.2, C26.2, C27.2, C32.2, C33.2, C34.2, C39.2, C40.2, C41.2, C42.2, C43.2, C44.1, C45.2, C46.1, C47.2, C48.2, C49.2, C50.2, C51.2, C52.2, C53.2, C54.2, C55.2, C56.2, C57.2, D2.3, D3.3, D4.3, D5.3, D6.3, D7.3, D8.3, D9.3, D10.3, D11.3, D12.3, D13.3, D14.3, D15.3, D16.3, D17.3, D18.3, D19.3, D20.3, D21.3, D22.3, D23.3, D24.3, D25.3, J2.5, J3.3, R4.1, R10.1, R14.1, R16.2, R17.2, R18.1, R23.2, R24.2, R31.2, SW1.1, SW2.1, SW3.1, SW4.1, SW5.1, SW6.1, U1.4, U2.2, U3.1, U3.18, U3.27, U3.39, U3.44, U3.45, U3.46, U3.47, U3.48, U3.49, U3.50, U4.8, U4.23, U4.35, U4.47, U5.7, U5.18, U5.21, U5.25, U5.26, U6.1, U7.2, U7.6, U9.2, U11.10, U11.13, U11.19, U11.24, U12.3, U12.4, U12.6, U12.11, c1.2, c2.2, c7.2, c8.2, c9.2, c10.2
LCD_CS: U4.22, U9.3
LCD_DC: U4.25, U9.5
LCD_LED: R7.2, U4.20, U9.8
LCD_SCK: U4.15, U9.7, U9.10
LCD_SDI: U4.17, U9.6, U9.12
LCD_SDO: U4.16, U9.9, U9.13
LCD_T_CS: U4.19, U9.11
LCD_T_Irq: U4.21, U9.14
LCD_rst: R6.2, U4.14, U9.4
MODE: U3.11, U4.29
unnamed: BT3.1, SW9.2, U12.1, U12.16, c10.1
unnamed: C28.1, U11.4
unnamed: C29.1, U11.11
unnamed: C30.1, U11.3
unnamed: C31.1, U11.12
unnamed: C32.1, R26.1, R27.1, U11.5, U11.9
unnamed: C33.1, R29.2, U11.14
unnamed: C35.1, U11.22
unnamed: C35.2, L2.1, U11.23
unnamed: C36.1, U11.21
unnamed: C36.2, L3.1, U11.20
unnamed: C37.1, U11.17
unnamed: C37.2, L4.1, U11.18
unnamed: C38.1, U11.26
unnamed: C38.2, L1.1, U11.25
unnamed: C44.2, L1.2, LS1.1
unnamed: C45.1, L2.2, LS1.2
unnamed: C46.2, L3.2, LS2.1
unnamed: C47.1, L4.2, LS2.2
unnamed: C49.1, U5.17
unnamed: D1.1, U12.7
unnamed: D1.2, R1.2
unnamed: D2.2, D6.4
unnamed: D3.2, D7.4
unnamed: D4.2, D8.4
unnamed: D5.2, D9.4
unnamed: D10.2, D14.4
unnamed: D6.2, D10.4
unnamed: D11.2, D15.4
unnamed: D7.2, D11.4
unnamed: D12.2, D16.4
unnamed: D8.2, D12.4
unnamed: D13.2, D17.4
unnamed: D9.2, D13.4
unnamed: D14.2, D18.4
unnamed: D15.2, D19.4
unnamed: D16.2, D20.4
unnamed: D17.2, D21.4
unnamed: D18.2, D22.4
unnamed: D19.2, D23.4
unnamed: D20.2, D24.4
unnamed: D21.2, D25.4
unnamed: D3.4, D22.2
unnamed: D4.4, D23.2
unnamed: D5.4, D24.2
unnamed: D26.1, R12.2
unnamed: D27.1, R13.2
unnamed: D28.1, JP7.1, R15.1, c2.1
unnamed: D28.2, L5.2, U7.1
unnamed: D29.1, R17.1
unnamed: J1.1, JP1.2, U3.14
unnamed: J1.2, JP2.2, U3.15
unnamed: J1.3, JP3.2, U3.16
unnamed: J1.4, JP4.2, U3.17
unnamed: J2.2, U5.16
unnamed: J2.3, U5.15
unnamed: JP8.2, R18.2, U4.44
unnamed: L6.1, U12.5
unnamed: L6.2, U12.2
unnamed: R2.1, R5.2, U1.3
unnamed: R3.1, R4.2, U1.2
unnamed: R9.1, R10.2, U1.6
unnamed: R8.1, R11.2, U1.5
unnamed: R12.1, U3.33
unnamed: R13.1, U3.32
unnamed: R14.2, U12.12, U12.13
unnamed: R15.2, R16.1, U7.3
unnamed: R23.1, R26.2, U11.8
unnamed: R24.1, R25.2, U11.6
unnamed: R25.1, R27.2, U11.7
unnamed: R28.1, U11.1, U11.2
unnamed: U12.14, c9.1
unnamed: U12.15, c8.1
RTS_BT: JP1.1, U4.32
RX: U4.13, U5.1
RX_BT: JP4.1, U4.30
Reset: C1.2, J3.5, SW1.2, U4.7
TX: U4.12, U5.5
TX_BT: JP3.1, U4.31
Vbat: L5.1, R30.1, SW9.1, U7.4, U7.5, c1.1
Vusb: J2.1, U12.8, U12.9, c7.1
WAKE: U3.21, U4.28
next: SW4.2, U3.7
pp: SW6.2, U3.8
prev: SW5.2, U3.9
vol+: SW2.2, U3.6
vol-: SW3.2, U3.10
