r078786/PE2_BS/Bluetooth_music_box/code/Test/Core/Inc/main.h

#define IN_LEFT_Pin GPIO_PIN_0
#define IN_LEFT_GPIO_Port GPIOA
#define IN_RIGHT_Pin GPIO_PIN_1
#define IN_RIGHT_GPIO_Port GPIOA
#define LCD_RST_Pin GPIO_PIN_4
#define LCD_RST_GPIO_Port GPIOA
#define BATTERY_Pin GPIO_PIN_0
#define BATTERY_GPIO_Port GPIOB
#define TOUCH_CS_Pin GPIO_PIN_1
#define TOUCH_CS_GPIO_Port GPIOB
#define BACKLIGHT_Pin GPIO_PIN_2
#define BACKLIGHT_GPIO_Port GPIOB
#define TOUCH_IRQ_Pin GPIO_PIN_10
#define TOUCH_IRQ_GPIO_Port GPIOB
#define LCD_CS_Pin GPIO_PIN_11
#define LCD_CS_GPIO_Port GPIOB
#define LCD_DC_Pin GPIO_PIN_12
#define LCD_DC_GPIO_Port GPIOB
#define EVENT_Pin GPIO_PIN_14
#define EVENT_GPIO_Port GPIOB
#define WAKE_Pin GPIO_PIN_15
#define WAKE_GPIO_Port GPIOB
#define MODE_Pin GPIO_PIN_8
#define MODE_GPIO_Port GPIOA
