r078786/PE2_BS/Bluetooth_music_box/code/Test/Core/Inc/ili9341.h

/* vim: set ai et ts=4 sw=4: */
#ifndef __ILI9341_H__
#define __ILI9341_H__

#include "fonts.h"
#include <stdbool.h>

#define ILI9341_MADCTL_MY  0x80
#define ILI9341_MADCTL_MX  0x40
#define ILI9341_MADCTL_MV  0x20
#define ILI9341_MADCTL_ML  0x10
#define ILI9341_MADCTL_RGB 0x00
#define ILI9341_MADCTL_BGR 0x08
#define ILI9341_MADCTL_MH  0x04

/*** Redefine if necessary ***/
#define ILI9341_SPI_PORT hspi1
extern SPI_HandleTypeDef ILI9341_SPI_PORT;

#define ILI9341_RES_Pin       GPIO_PIN_4
#define ILI9341_RES_GPIO_Port GPIOA
#define ILI9341_CS_Pin        GPIO_PIN_11
#define ILI9341_CS_GPIO_Port  GPIOB
#define ILI9341_DC_Pin        GPIO_PIN_12
#define ILI9341_DC_GPIO_Port  GPIOB

// default orientation
/*
#define ILI9341_WIDTH  240
#define ILI9341_HEIGHT 320
#define ILI9341_ROTATION (ILI9341_MADCTL_MX | ILI9341_MADCTL_BGR)
*/

// rotate right

#define ILI9341_WIDTH  320
#define ILI9341_HEIGHT 240
#define ILI9341_ROTATION (ILI9341_MADCTL_MX | ILI9341_MADCTL_MY | ILI9341_MADCTL_MV | ILI9341_MADCTL_BGR)


// rotate left
/*
#define ILI9341_WIDTH  320
#define ILI9341_HEIGHT 240
#define ILI9341_ROTATION (ILI9341_MADCTL_MV | ILI9341_MADCTL_BGR)
*/

// upside down
/*
#define ILI9341_WIDTH  240
#define ILI9341_HEIGHT 320
#define ILI9341_ROTATION (ILI9341_MADCTL_MY | ILI9341_MADCTL_BGR)
*/

/****************************/

// Color definitions
#define	LCD_BLACK   0x0000
#define	LCD_BLUE    0x001F
#define	LCD_RED     0xF800
#define	LCD_GREEN   0x07E0
#define LCD_CYAN    0x07FF
#define LCD_MAGENTA 0xF81F
#define LCD_YELLOW  0xFFE0
#define LCD_WHITE   0xFFFF
#define LCD_COLOR565(r, g, b) (((r & 0xF8) << 8) | ((g & 0xFC) << 3) | ((b & 0xF8) >> 3))

// call before initializing any SPI devices
void ILI9341_Unselect();

void ILI9341_LCD_Init(void);
void LCD_DrawPixel(uint16_t x, uint16_t y, uint16_t color);
void LCD_WriteString(uint16_t x, uint16_t y, const char* str, FontDef font, uint16_t color, uint16_t bgcolor);
void LCD_FillRectangle(uint16_t x, uint16_t y, uint16_t w, uint16_t h, uint16_t color);
void LCD_FillScreen(uint16_t color);
void LCD_DrawImage(uint16_t x, uint16_t y, uint16_t w, uint16_t h, const uint16_t* data);
void LCD_InvertColors(bool invert);
void LCD_DrawHLine(uint16_t x, uint16_t y,uint16_t x_, uint16_t y_, uint16_t color);
void LCD_DrawVLine(uint16_t x, uint16_t y,uint16_t x_, uint16_t y_, uint16_t color);

#endif // __ILI9341_H__
