r078786/PE2_BS/(commit log)

2021-03-08 BlueTooth Speaker
    [Audio_Amplifier.sch, BOM.xlsx, Battery_Charge_Circuit.sch, Bluetooth_Speaker.kicad_pcb, Bluetooth_Speaker.sch, LEDS.sch, USB-C_Charger.sch, amplifier_BT.sch]
2021-03-08 Update BOM.xlsx
    Added some order links
    [BOM.xlsx]
2021-03-08 aanpassing schema en pcb
    oplossing voor audiosignalen
    in excel nog enkele links toegevoegd
    [BOM.xlsx, schema_v1.kicad_pcb, schema_v1.sch]
2021-03-09 aanpassingen bom, gerber files voor bestelling
    [BOM.xlsx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]
2021-03-16 eerste code test
    nog niet getest, enkel geschreven
    [BOM.xlsx, schema_v1.kicad_pcb]
2021-03-17 Nieuwe start
    Nieuw schema (andere µC, BT-module, dc/dc, verschillversterkers)
    [BT.sch, Buttons.sch, LEDS.sch, STM32G0.sch, amplifier_BT.sch, batterij.sch, schema_v1.kicad_pcb, schema_v1.sch]
2021-03-17 Werken aan positionering componenten op pcb
    kleine aanpassingen op schema (zoals verbinding leds - µc)
    [BOM.xlsx, LEDS.sch, STM32G0.sch, batterij.sch, schema_v1.kicad_pcb, schema_v1.sch]
2021-03-18 pcb componenten goed gepositioneerd (pcb_v3)
    [schema_v1.kicad_pcb]
2021-03-18 Tracks tekenen op pcb
    [BOM.xlsx, schema_v1.kicad_pcb]
2021-03-19 pcb af
    laatste tracks verbonden
    [schema_v1.kicad_pcb]
2021-03-21 pcb af en gerbers aangemaakt om te bestellen
    [schema_v1-B_Cu.gbr, schema_v1-B_Mask.gbr, schema_v1-B_Paste.gbr, schema_v1-B_SilkS.gbr, schema_v1-Edge_Cuts.gbr, schema_v1-F_Cu.gbr, schema_v1-F_Mask.gbr, schema_v1-F_Paste.gbr]
2021-03-23 New repository
    New repository zodat ik kon werken in eclipse
    [Audio_Amplifier.sch, BOM.xlsx, BT.sch, Battery_Charge_Circuit.sch, Bluetooth_Speaker.kicad_pcb, Bluetooth_Speaker.sch, Buttons.sch, LEDS.sch]
2021-03-23 Final gerbers en eerste keer beginnen aan code
2021-03-24 Poging voor ili9341 driver
    Mislukt
2021-03-30 Aanpassing code bestanden
    errors fixed
    [ili9341_touch.c]
2021-03-30 Eerste testcode voor lcd
    Namen van functies van library veranderd
    op het scherm: kleuren weergeven, figuren, test met touch
    NOG NIET GETEST (pcb nog niet aangekomen)
2021-04-07 Clean UP
    [Test Run.cfg, schema_v1.kicad_pcb]
2021-04-09 Poging tot LCD aan te praat te krijgen
    Niet gelukt, scherm ligt enkel op tijdens start en einde van de console in stm workbench
2021-04-12 poging tot leds aan te sturen
    library + heel klein stukje testcode
    nog niet getest
2021-04-12 geprobeerd om iets te vinden over ws2812 leds
    niks gevonden..
2021-04-18 Touch geregeld, leds nog niet
    touch: 2 pins omgewisseld in de defines, snelheid spi veranderd
2021-04-20 poging tot images op lcd
    De afbeeldingen komen wel op het scherm, maar 90 graden gedraaid. Nog niet opgelost.
2021-04-26 enkel "mode-pin" aangestuurd voor poging tot BT module
    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
2021-04-27 Library en uitvoering LEDS
    Werkt !
    adc ingang lezen en aansturen op leds nog niet....
2021-04-27 poging tot adc
    niet gelukt
2021-04-28 Gestart aan eindeverslag
    Structuur gegeven aan het verslag + heel de intro + kleine start van verslag zelf
2021-04-28 Aan verslag gewerkt
    Componenten toegevoegd, schematic deels uitgelegd
    [batterij.sch, bom.csv, schema_v1.kicad_pcb]
2021-05-02 prutsen met touch voor leds aan te sturen
    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
2021-05-02 ADC audio werkt deels
    constante waarde op scherm
    [BT.sch]
2021-05-02 hardware en behuizing aan verslag toegevoegd
    foto's geupload met een beetje tekst
2021-05-03 geprobeerd om adc werkend te krijgen + hoofdscherm aangepast
    niet gelukt.
    hoofdscherm andere layout
    toggle lcd_led functie
2021-05-04 Kan communiceren met BT via uart
    +LEDS13-24 werken niet meer
2021-05-09 klein beetje extra commentaar in code + toevoeging WS2812 in verslag
    Enkele dingen toegevoegd in het verslag
    grootste punt: Software; WS2812 aansturing helemaal uitgelegd
2021-05-13 behuizing getekend
    [back.dxf, bot.dxf, front.dxf, left.dxf, right.dxf, top.dxf]
2021-05-13 Clean gemaakt + led effect + power check
    code proper gemaakt:
    functies gemaakt, nutteloze code weggedaan
    led effect: regenboog
    power check: LCD / LEDs aan/uit
2021-05-17 behuizing gemaakt
    [back.dxf, bot.dxf, front.dxf, right.dxf, top.dxf]
2021-05-18 Voorbereiding verdediging
    poging tot meerdere effecten (code in apart bestand)
    Powerpoint gemaakt
    Verslag zo goed als af
    [BT.sch]
2021-05-21 Clear van bestanden + klaarmaken om up te loaden
    Onnodige bestanden verwijderd
    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
    [Audio_Amplifier.sch, BOM.xlsx, BT.sch, Battery_Charge_Circuit.sch, Bluetooth_Speaker.kicad_pcb, Bluetooth_Speaker.sch, Buttons.sch, LEDS.sch]
2021-05-21 Verslag AF
    [temp_bom.xlsx]
